kkrizka/powerboard_mass_test_adapter_active/bom.ods

Reference | Quantity | Value | Footprint | Datasheet | DigiKey | Cost / Item | Total Cost | 143.11
C303 C304 C305 C308 C310 C312 C313 C803 C804 | 9 | 10uF | Capacitors_SMD:C_0805 |  |  |  | 0
C101 C102 C103 C104 C106 C111 C112 C113 C114 C115 C116 C117 C118 C119 C301 C302 C306 C307 C309 C311 C314 C605 C802 C805 C9002 | 25 | 0.1uF | Capacitors_SMD:C_0805 |  |  |  | 0
C701 C703 C705 | 3 | 0.1μF | Capacitors_SMD:C_0805 |  |  |  | 0
C702 C704 C706 | 3 | 10μF | Capacitors_SMD:C_0805 |  |  |  | 0
C801 | 1 | C | Capacitors_SMD:C_0805 |  |  |  | 0
C9001 C9004 C9005 C9006 | 4 | 1uF | Capacitors_SMD:C_0805 |  |  |  | 0
D101 D102 D103 D104 D105 D106 D107 D108 D109 D701 D702 D703 D704 D705 D706 D707 D708 D709 D901 D902 | 20 | LED | LEDs:LED_1206_HandSoldering | https://www.lumex.com/content/files/ProductAttachment/SML-LX1206IW-TR.pdf | 67-1003-1-ND | 0.44 | 8.8
FL801 | 1 | 4700-003MLF | lbl_filters:4700-008MLF | http://www.ctscorp.com/wp-content/uploads/2016/01/4700-003.pdf | 410-1193-1-ND | 1.33 | 1.33
J1 | 1 | CONN_03X32 | lbl_conn:DIN-SIGNAL_R096FS-3_0C1-2 | https://b2b.harting.com/files/download/PRD/PDF_TS/0973296X801_100104712DRW068A.pdf | 1195-2893-ND | 4.95 | 4.95
J14001 J14002 J14003 J14004 J14005 J14006 J14007 | 7 | CONN_01X06 | Socket_Strips:Socket_Strip_Angled_1x06_Pitch2.54mm | http://www.sullinscorp.com/drawings/78_P(N)PxCxx1LGBN-RC,_10493-G.pdf | S5481-ND | 0.66 | 4.62
J2 | 1 | CONN_01X02 | Pin_Headers:Pin_Header_Straight_1x02_Pitch2.54mm_SMD_Pin1Right | https://www.molex.com/pdm_docs/sd/878980204_sd.pdf | WM9852-ND | 0.47 | 0.47
J201 J202 | 2 | CONN_02X10 | Pin_Headers:Pin_Header_Straight_2x10_Pitch2.54mm_SMD | http://www.sullinscorp.com/drawings/78_P(N)PxCxx1LGBN-RC,_10493-G.pdf | WM17456-ND | 1.92 | 3.84
J3 | 1 | Conn_02x18_Odd_Even | Pin_Headers:Pin_Header_Straight_2x18_Pitch2.54mm_SMD | http://www.sullinscorp.com/images/C10059.pdf | S2331E-18-ND | 3.23 | 3.23
J4 | 1 | Conn_02x09_Odd_Even | Socket_Strips:Socket_Strip_Straight_2x09_Pitch2.54mm_SMD | https://www.molex.com/pdm_docs/sd/015912180_sd.pdf | WM17455-ND | 1.43 | 1.43
J5 J6 | 2 | CONN_02X06 | Socket_Strips:Socket_Strip_Straight_2x06_Pitch2.54mm_SMD | https://cdn.amphenol-icc.com/media/wysiwyg/files/drawing/95278.pdf | 609-5754-ND | 0.78 | 1.56
J801 | 1 | CONN_02X02 | Connectors_Molex:Molex_MiniFit-JR-5569-04A2_2x02x4.20mm_Angled | https://www.molex.com/pdm_docs/pk/PK-5569-002.pdf | WM21364-ND | 2.08 | 2.08
J802 | 1 | CONN_02X01 | lbl_conn:TerminalBlock_Pheonix_MKDS5-2pol | https://media.digikey.com/pdf/Data%20Sheets/Phoenix%20Contact%20PDFs/1714971.pdf | 277-1271-ND | 1.6 | 1.6
J803 | 1 | LEMO2 | lbl_conn:lemo_epb00250ntn | http://www.lemo.com/pdf/EPB.00.250.NTN.pdf | 1124-1424-ND | 21.15 | 21.15
J901 | 1 | CONN_02X04 | Pin_Headers:Pin_Header_Straight_2x04_Pitch2.54mm_SMD | https://www.molex.com/pdm_docs/sd/015910080_sd.pdf | WM17458-ND | 0.74 | 0.74
JP1201 JP1202 JP1203 | 3 | Jumper_NC_Dual | Pin_Headers:Pin_Header_Straight_1x03_Pitch2.54mm_SMD_Pin1Right | http://support.sullinscorp.com/attachments/token/zIL3zA2RvRp1z4YZ6UU4t3JTD/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 | S1013EC-03-ND | 0.25 | 0.75
JP901 JP902 JP903 | 3 | Jumper | Pin_Headers:Pin_Header_Straight_1x02_Pitch2.54mm_SMD_Pin1Right | https://www.molex.com/pdm_docs/sd/878980204_sd.pdf | WM9852-ND | 0.47 | 1.41
Q101 Q102 Q103 Q104 Q105 Q106 Q107 Q108 Q109 | 9 | BSH105,215 | TO_SOT_Packages_SMD:SOT-23 | https://assets.nexperia.com/documents/data-sheet/BSH105.pdf | 1727-4924-1-ND | 0.56 | 5.04
Q111 Q112 Q113 Q114 Q115 Q116 Q117 Q118 Q119 | 9 | NTD4858N | TO_SOT_Packages_SMD:TO-252-2 | http://www.onsemi.com/pub/Collateral/NTD4858N-D.PDF | NTD4858NT4GOSCT-ND | 0.8 | 7.2
Q701 Q702 Q703 Q704 Q705 Q706 Q707 Q708 Q709 | 9 | SSM3J355R | TO_SOT_Packages_SMD:SOT-23 | https://toshiba.semicon-storage.com/info/docget.jsp?did=55743&prodName=SSM3J355R | SSM3J355RLFCT-ND | 0.5 | 4.5
R101 R102 R103 R104 R105 R106 R107 R108 R109 R701 R702 R703 R704 R705 R706 R707 R708 R709 R902 R903 | 20 | 620 | Resistors_SMD:R_0805 | http://www.vishay.com/docs/20035/dcrcwe3.pdf | 541-620CCT-ND | 0.1 | 2
R111 R112 R113 R114 R115 R116 R117 R118 R119 | 9 | 25m | Resistors_SMD:R_2512 | https://riedon.com/media/pdf/CSR.pdf | 696-1675-1-ND | 0.64 | 5.76
R1203 R1204 R1205 R1211 R1212 R1213 R1214 R1215 R1216 R1217 R1218 R1219 R1221 R1222 R1223 R1224 R1225 R1226 R1227 R1228 R1229 R1230 R1231 R1232 R1233 R1234 R1235 R1236 R1240 R1241 R1242 R1243 R1244 R1245 R1246 | 35 | 2k | Resistors_SMD:R_0805 | http://www.vishay.com/docs/28773/crcwce3.pdf | 541-4134-1-ND | 0.1 | 3.5
R131 R132 R133 R134 R135 R136 R137 R138 R139 | 9 | 4.02k | Resistors_SMD:R_0805 | http://www.vishay.com/docs/20035/dcrcwe3.pdf | 541-4.02KCCT-ND | 0.1 | 0.9
R141 R142 R143 R144 R145 R146 R147 R148 R149 R151 R152 R153 R154 R155 R156 R157 R158 R159 R301 R302 R303 R304 R305 R306 R307 | 25 | 10k | Resistors_SMD:R_0805 |  |  |  | 0
R1200 R1201 R1202 R1206 R121 R122 R123 R124 R125 R126 R127 R128 R129 R308 R309 R310 R720 R721 R807 R901 R907 | 21 | 100k | Resistors_SMD:R_0805 |  |  |  | 0
R711 R712 R713 R714 R715 R716 R717 R718 R719 | 9 | 30k | Resistors_SMD:R_0805 |  |  |  | 0
R801 | 1 | R | Resistors_SMD:R_0805 |  |  |  | 0
R802 | 1 | 5m | Resistors_SMD:R_2512 | http://www.vishay.com/docs/20019/rcwe.pdf | 541-2727-1-ND | 0.68 | 0.68
R803 R804 | 2 | 100m | Resistors_SMD:R_0805 |  |  |  | 0
R805 | 1 | 35k | Resistors_SMD:R_0805 |  |  |  | 0
R806 | 1 | 90.9k | Resistors_SMD:R_0805 |  |  |  | 0
R812 | 1 | 250k | Resistors_SMD:R_0805 |  |  |  | 0
R813 R814 | 2 | 500k | Resistors_SMD:R_0805 |  |  |  | 0
R904 | 1 | 83k | Resistors_SMD:R_0805 |  |  |  | 0
R905 | 1 | 140k | Resistors_SMD:R_0805 |  |  |  | 0
R906 R908 | 2 | 25k | Resistors_SMD:R_0805 |  |  |  | 0
TH301 TH302 TH303 TH304 TH305 TH306 TH307 | 7 | Thermistor_NTC | Resistors_SMD:R_0805 | https://product.tdk.com/info/en/catalog/datasheets/503022/tpd_automotive_ntc-thermistor_ntcg_en.pdf | 445-180089-1-ND | 0.3 | 2.1
U101 U102 U103 | 3 | LM324 | Housings_SSOP:TSSOP-14_4.4x5mm_Pitch0.65mm | http://www.ti.com/lit/ds/symlink/lm324k.pdf | 296-18453-1-ND | 0.49 | 1.47
U1201 U1202 | 2 | TCA9548A_TSSOP | Housings_SSOP:TSSOP-24_4.4x7.8mm_Pitch0.65mm | http://www.ti.com/lit/ds/symlink/tca9548a.pdf | 296-34905-1-ND | 1.55 | 3.1
U301 U304 | 2 | AD7997 | Housings_SSOP:TSSOP-20_4.4x6.5mm_Pitch0.65mm | http://www.analog.com/media/en/technical-documentation/data-sheets/AD7997_7998.pdf | AD7997BRUZ-0-ND | 5.94 | 11.88
U302 U303 U305 | 3 | DAC5574 | Housings_SSOP:MSOP-10_3x3mm_Pitch0.5mm | http://www.ti.com/lit/ds/symlink/dac5574.pdf | 296-48522-1-ND | 3.72 | 11.16
U701 U702 U703 | 3 | MCP3428 | Housings_SSOP:TSSOP-14_4.4x5mm_Pitch0.65mm | http://www.microchip.com/mymicrochip/filehandler.aspx?ddocname=en546216 | MCP3428-E/SL-ND | 3.67 | 11.01
U801 | 1 | AD7993 | Housings_SSOP:TSSOP-16_4.4x5mm_Pitch0.65mm | http://www.analog.com/media/en/technical-documentation/data-sheets/AD7993_7994.pdf | AD7993BRUZ-0-ND | 6.6 | 6.6
U802 U803 U804 | 3 | INA138 | TO_SOT_Packages_SMD:SOT-23-5_HandSoldering | http://www.ti.com/lit/ds/symlink/ina138.pdf | 296-17936-1-ND | 1.74 | 5.22
U901 | 1 | LM321 | TO_SOT_Packages_SMD:SOT-23-5_HandSoldering | http://www.ti.com/lit/ds/symlink/lm321.pdf | LM321MFX/NOPBCT-ND | 0.65 | 0.65
U902 U903 | 2 | ADP123 | TO_SOT_Packages_SMD:TSOT-23-5_HandSoldering | http://www.analog.com/media/en/technical-documentation/data-sheets/ADP122_123.pdf | ADP123AUJZ-R7CT-ND | 1.19 | 2.38
ZED201 | 1 | MicroZed | zed:microzed_noholes | http://www.zedboard.org/product/microzed | AES-Z7MB-7Z010-G | 0 | 0
 | 2 | BergStak 100 Position Connector Plug | zed:microzed_noholes | https://cdn.amphenol-icc.com/media/wysiwyg/files/drawing/61083.pdf | 609-1693-1-ND | 7.46 | 14.92
