kkrizka/powerboard_mass_test_adapter_active/schematic/pbv2_mass_test_adapter_active.pdf

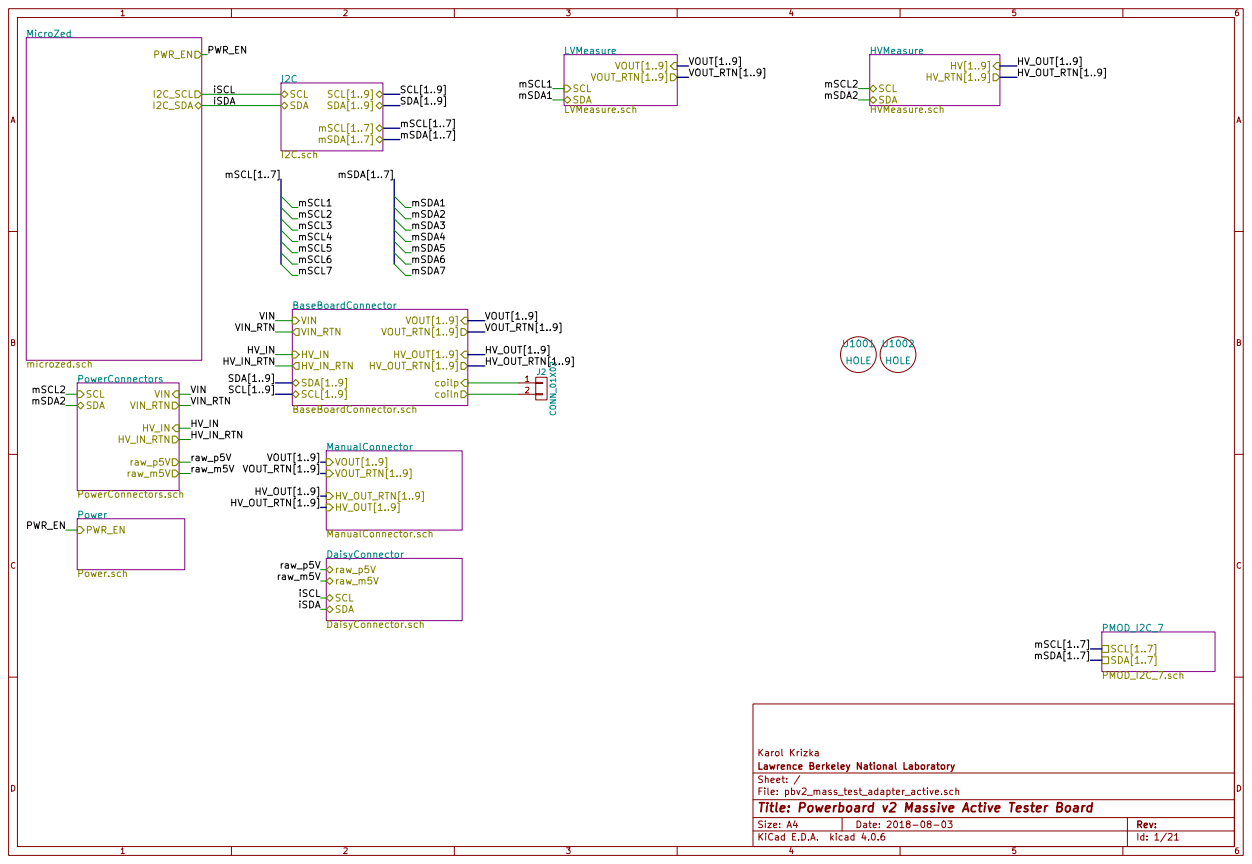
[picture p1: page 1]

File: pbv2_mass_test_adapter_active.sch Sheet: / Lawrence Berkeley National Laboratory Karol Krizka

Id: 1/21 Title: Powerboard v2 Massive Active Tester Board

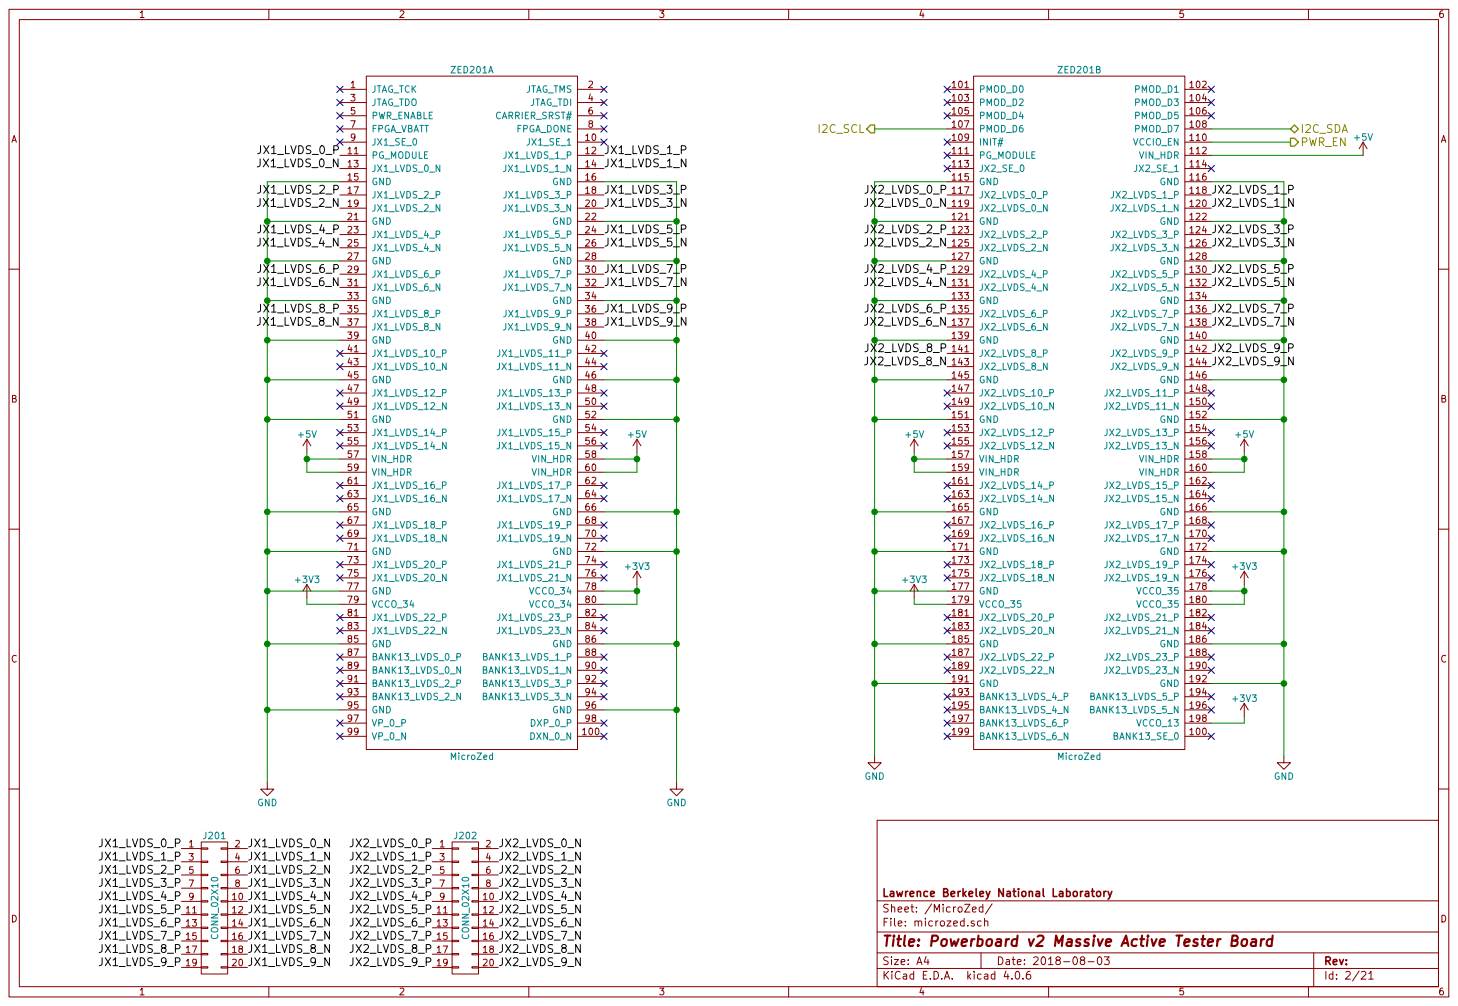
[picture p2: page 2]

File: microzed.sch Sheet: /MicroZed/ Lawrence Berkeley National Laboratory

Id: 2/21 Title: Powerboard v2 Massive Active Tester Board

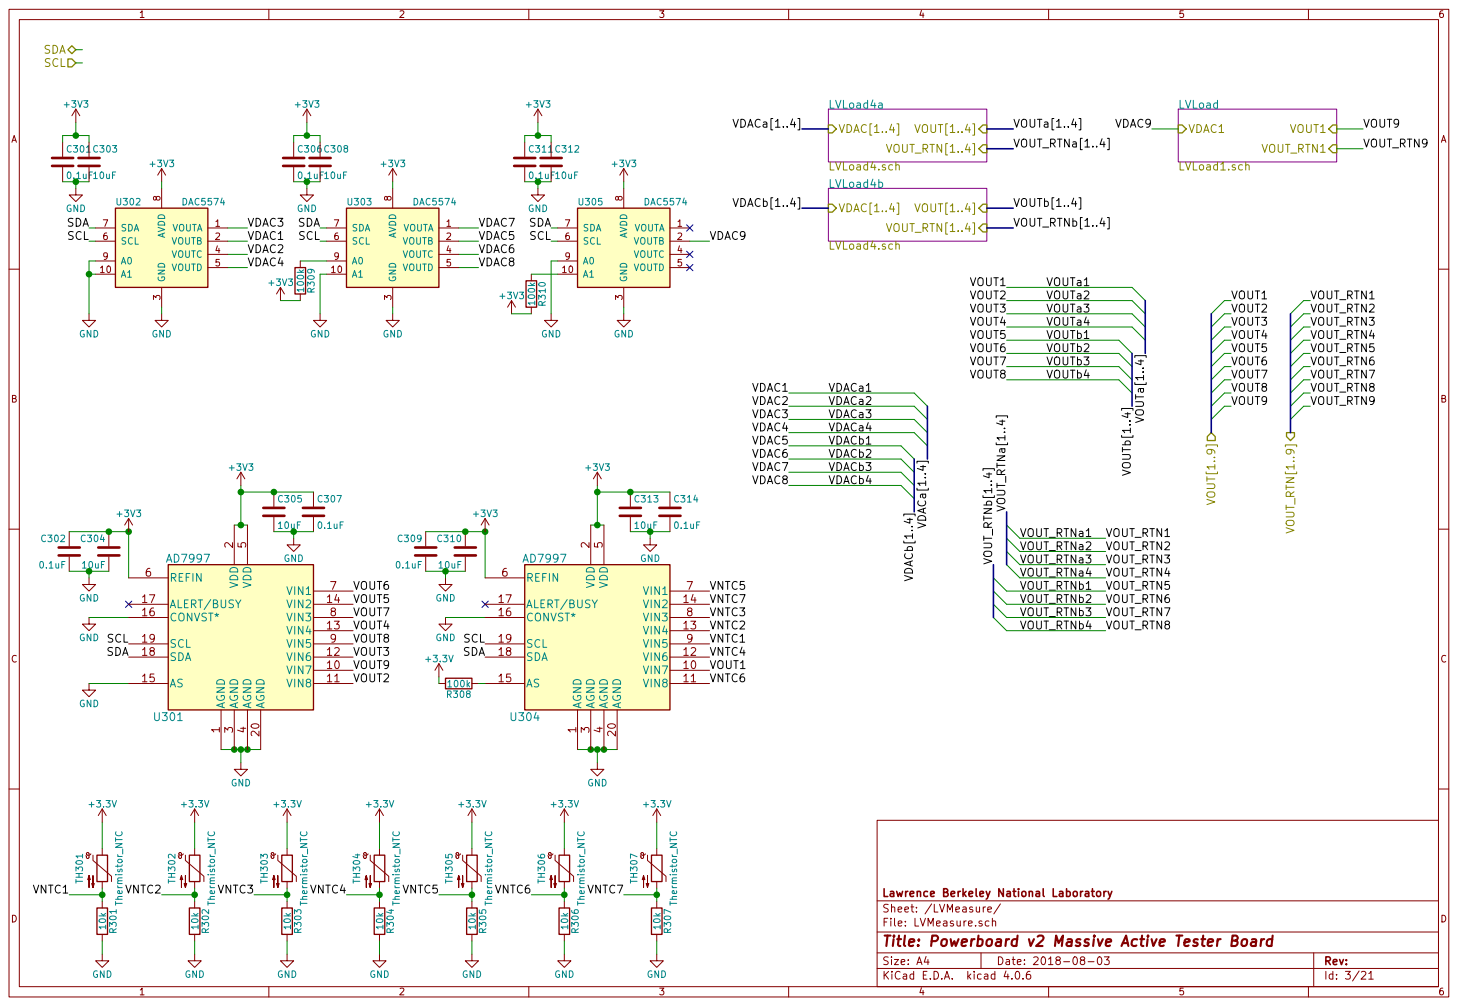
[picture p3: page 3]

3 VOUTC 4 VOUTD 5 SCL 6 SDA 7 AVDD

5 REFIN 6 VIN1 7 VIN3 8 VIN5 9 VIN7 10 AGND 20 VIN8 11 VIN6 12 VIN4 13 VIN2 14 AS 15 CONVST* 16 ALERT/BUSY 17 SDA 18 SCL 19U304AD7997 R301 10k TH301 Thermistor_NTC

5 REFIN 6 VIN1 7 VIN3 8 VIN5 9 VIN7 10 AGND 20 VIN8 11 VIN6 12 VIN4 13 VIN2 14 AS 15 CONVST* 16 ALERT/BUSY 17 SDA 18 SCL 19U301AD7997 VOUT9 GND SCL

File: LVMeasure.sch Sheet: /LVMeasure/ Lawrence Berkeley National Laboratory

Id: 3/21 Title: Powerboard v2 Massive Active Tester Board

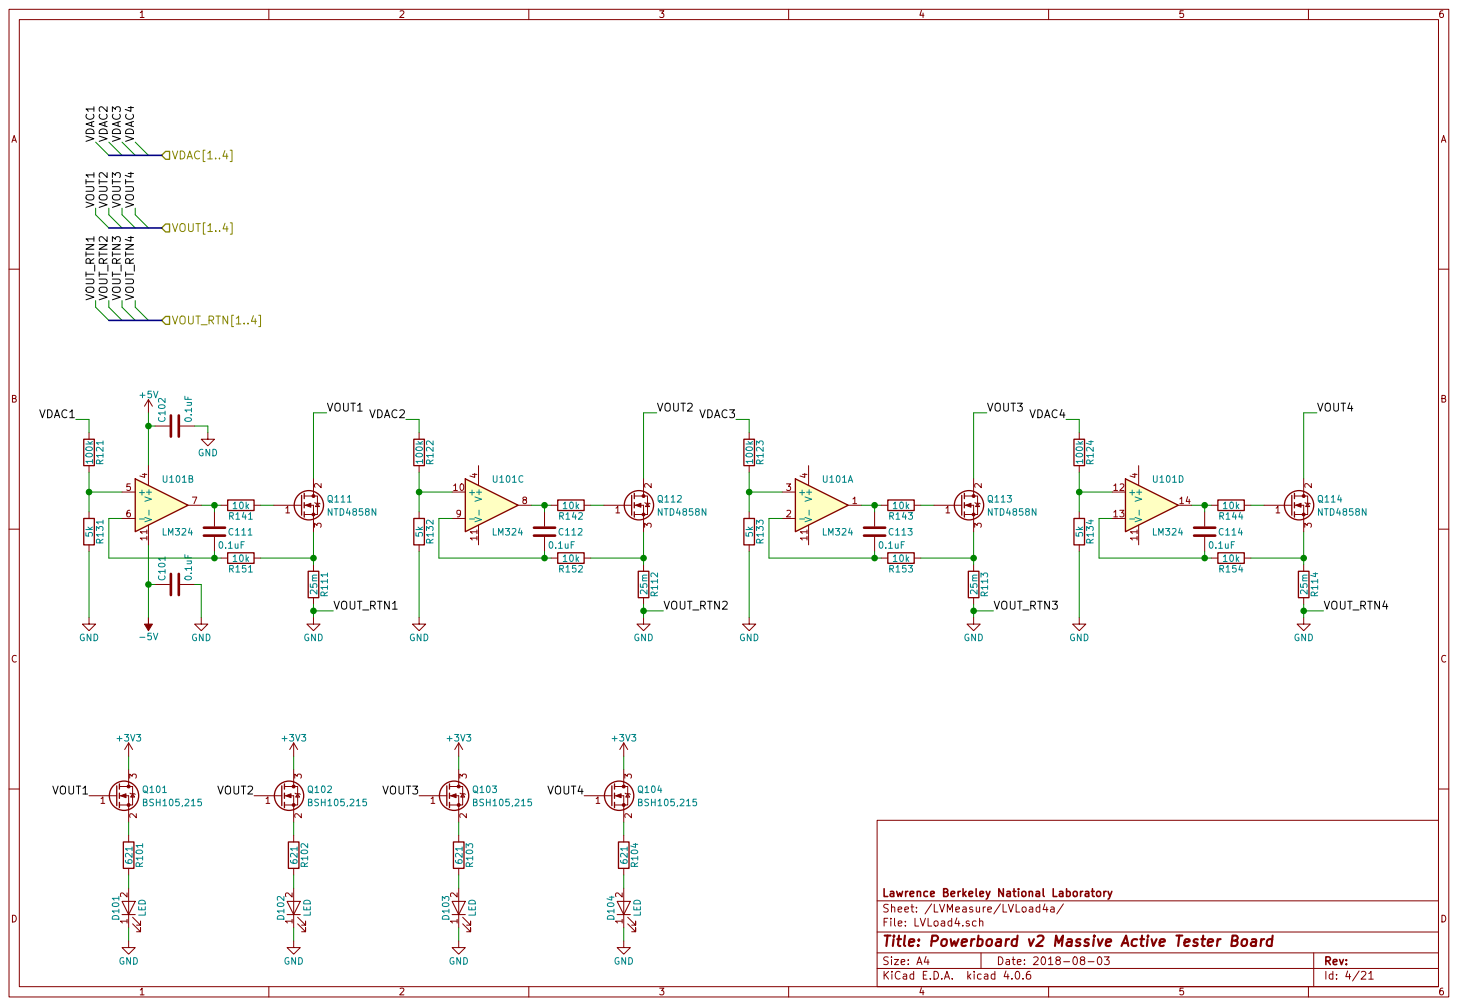
[picture p4: page 4]

File: LVLoad4.sch Sheet: /LVMeasure/LVLoad4a/ Lawrence Berkeley National Laboratory V+

2 3 Q114 NTD4858N GND GND GND GND

Id: 4/21 Title: Powerboard v2 Massive Active Tester Board

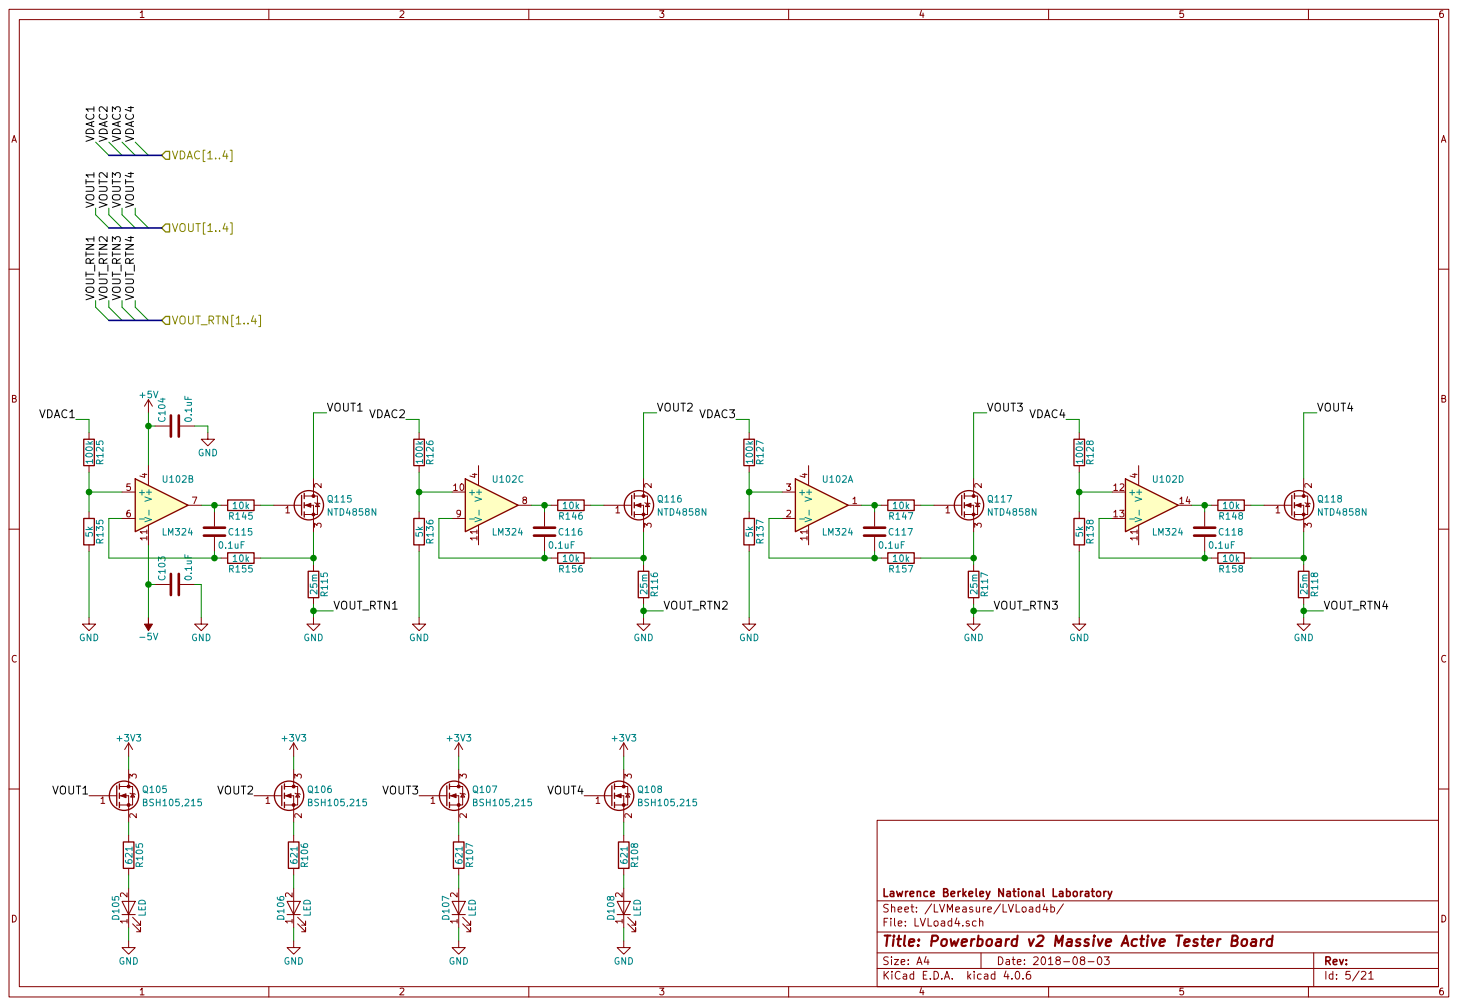
[picture p5: page 5]

File: LVLoad4.sch Sheet: /LVMeasure/LVLoad4b/ Lawrence Berkeley National Laboratory V+

2 3 Q118 NTD4858N GND GND GND GND

Id: 5/21 Title: Powerboard v2 Massive Active Tester Board

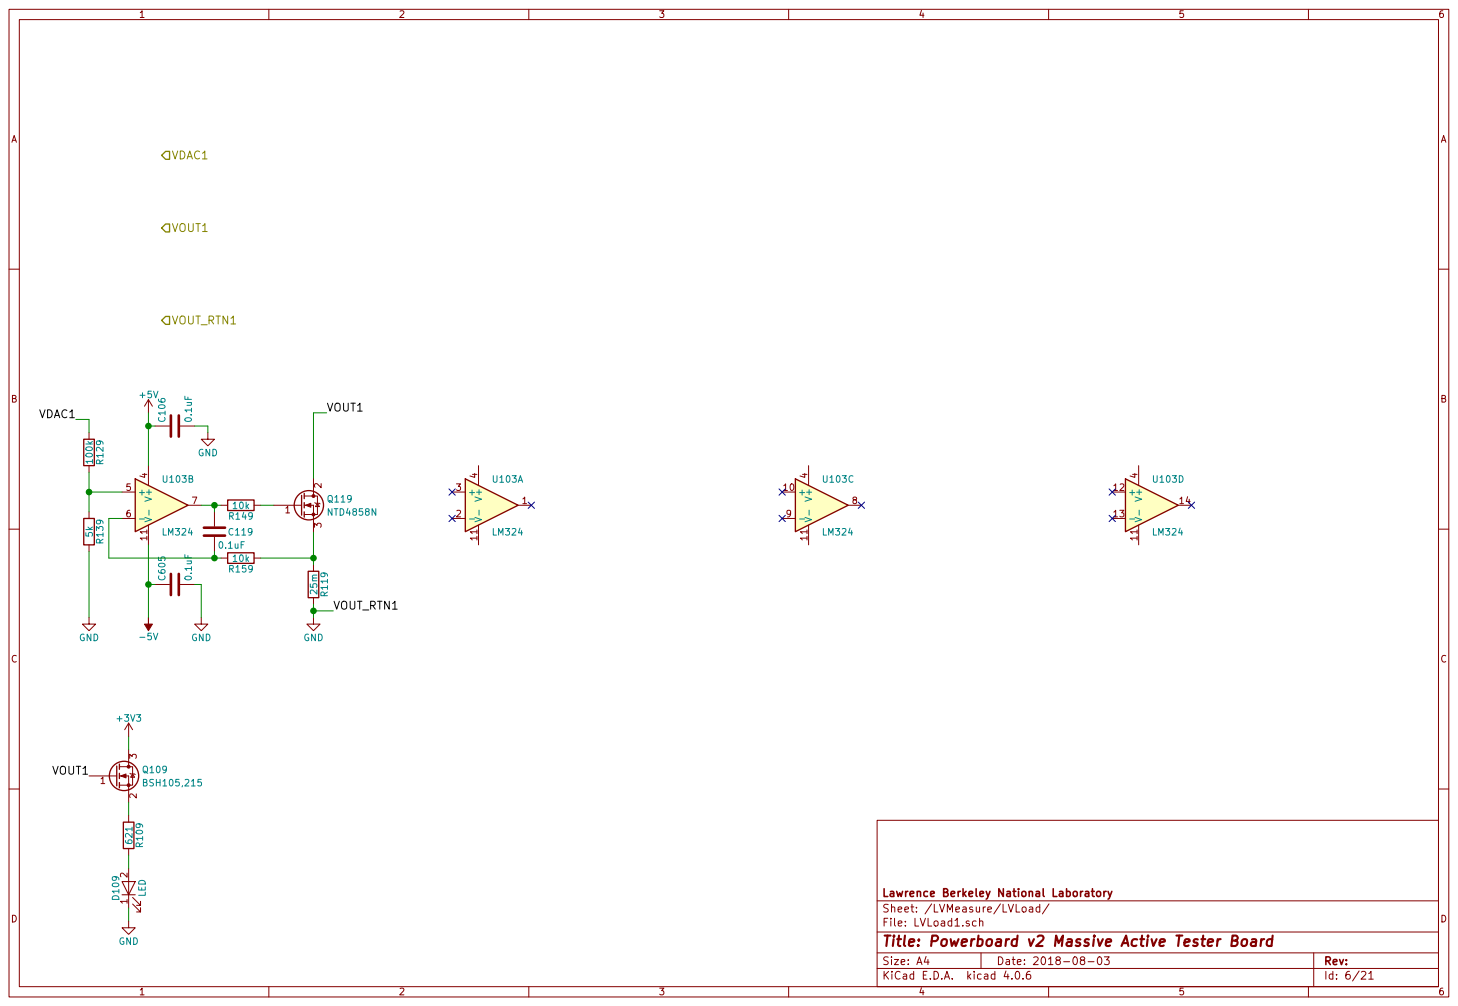
[picture p6: page 6]

File: LVLoad1.sch Sheet: /LVMeasure/LVLoad/ Lawrence Berkeley National Laboratory V+

Id: 6/21 Title: Powerboard v2 Massive Active Tester Board

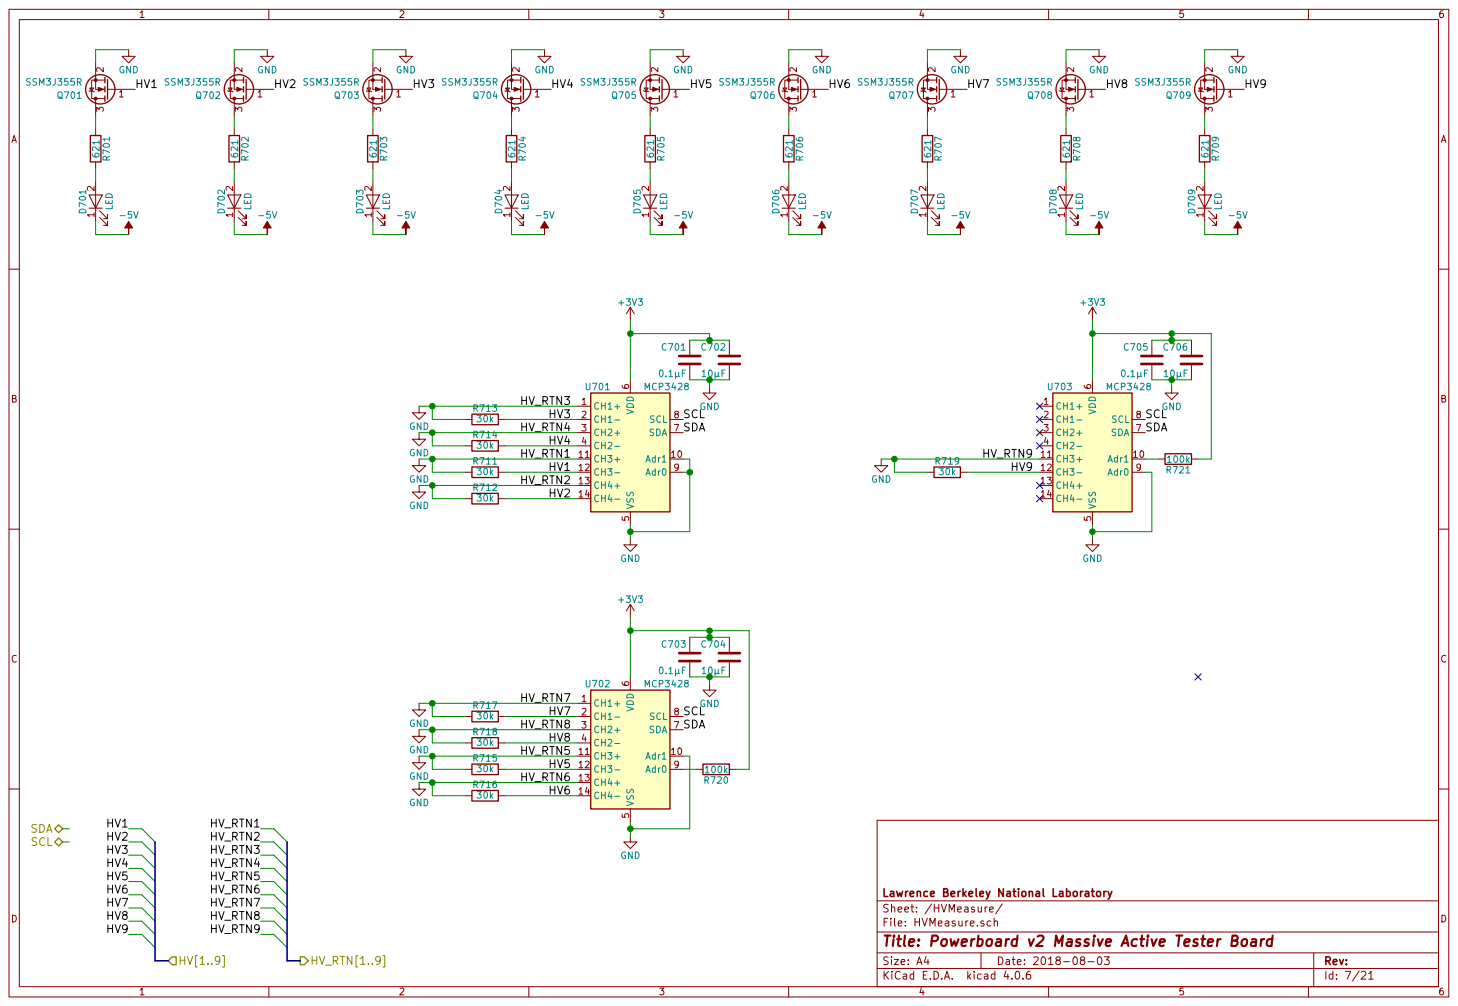
[picture p7: page 7]

6 SDA 7 SCL 8 Adr0 9 Adr1 10 CH3+ 11 CH3- 12 CH4+ 13 CH4- 14U701 MCP3428 GND GND GND GND GND GND GND GND GND GND GND GND GND GND GND GND GND GND

File: HVMeasure.sch Sheet: /HVMeasure/ Lawrence Berkeley National Laboratory

Id: 7/21 Title: Powerboard v2 Massive Active Tester Board

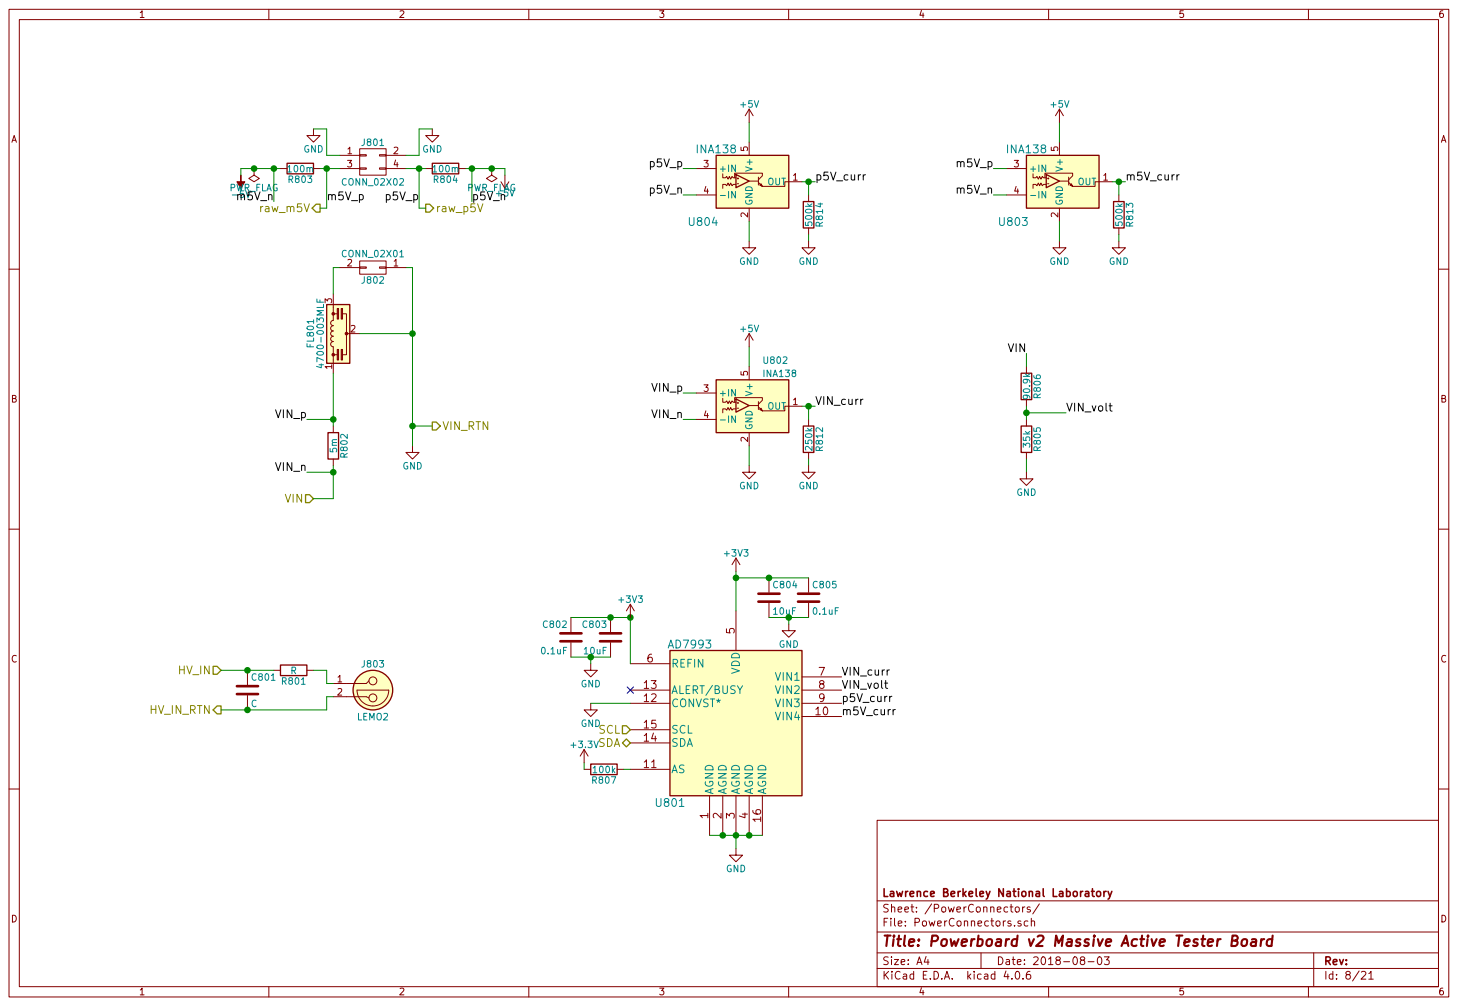
[picture p8: page 8]

5 REFIN 6 VIN1 7 VIN2 8 VIN3 9 VIN4 10 AS 11 CONVST* 12 ALERT/BUSY 13 SDA 14 SCL 15 AGND 16 U801AD7993 VIN_volt GND GND

File: PowerConnectors.sch Sheet: /PowerConnectors/ Lawrence Berkeley National Laboratory

Id: 8/21 Title: Powerboard v2 Massive Active Tester Board

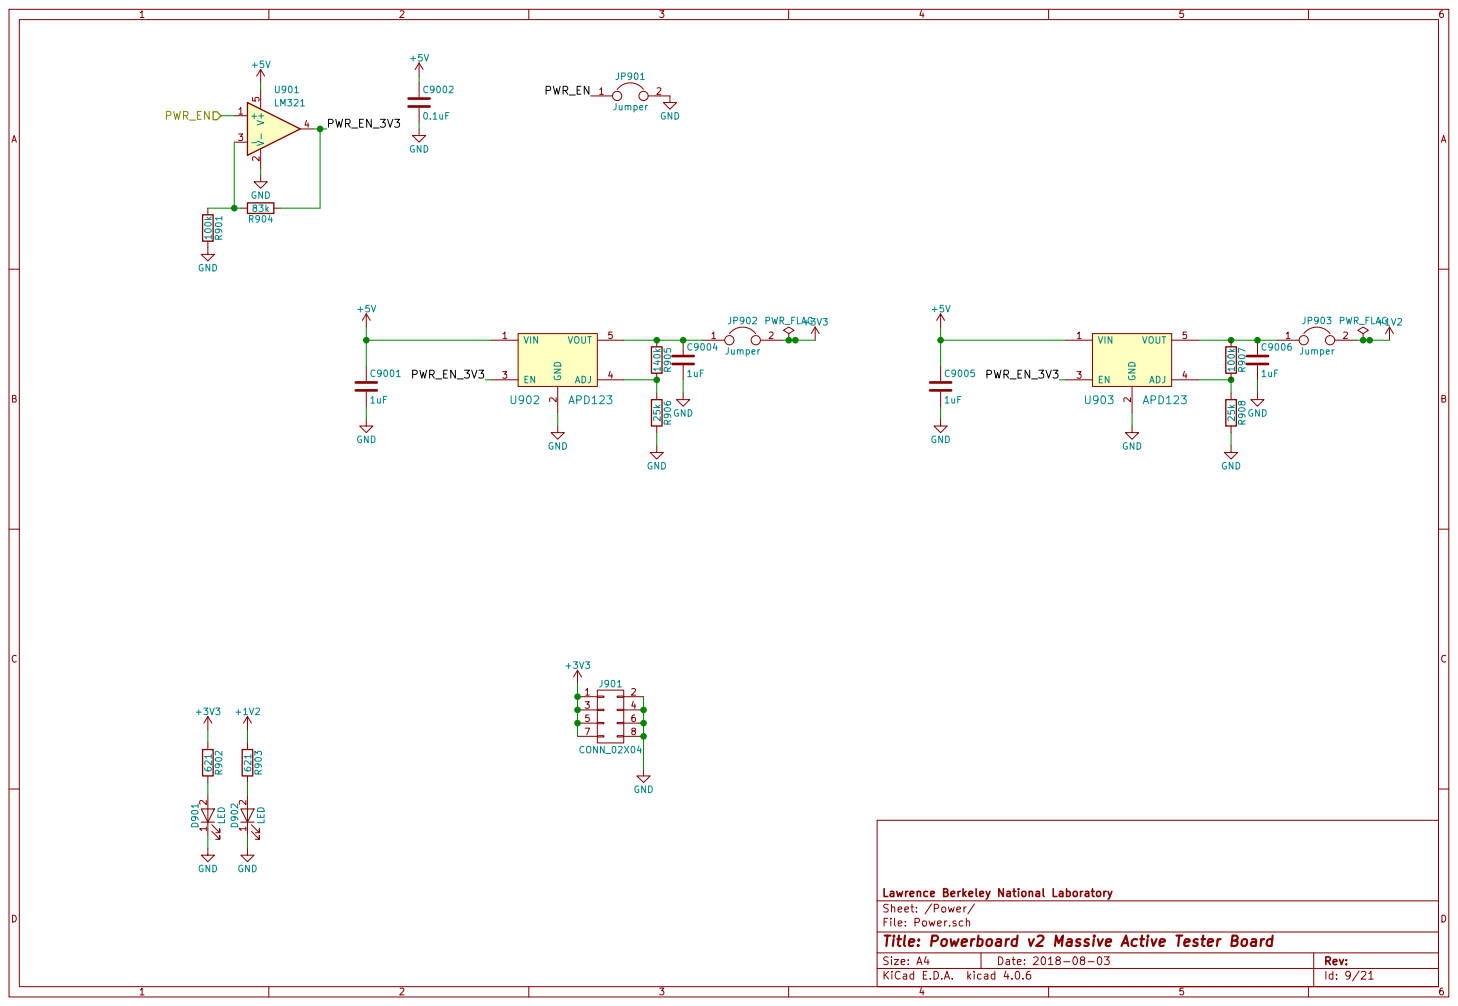
[picture p9: page 9]

File: Power.sch Sheet: /Power/ Lawrence Berkeley National Laboratory GND140k R905 R906 25k C9001

Id: 9/21 Title: Powerboard v2 Massive Active Tester Board

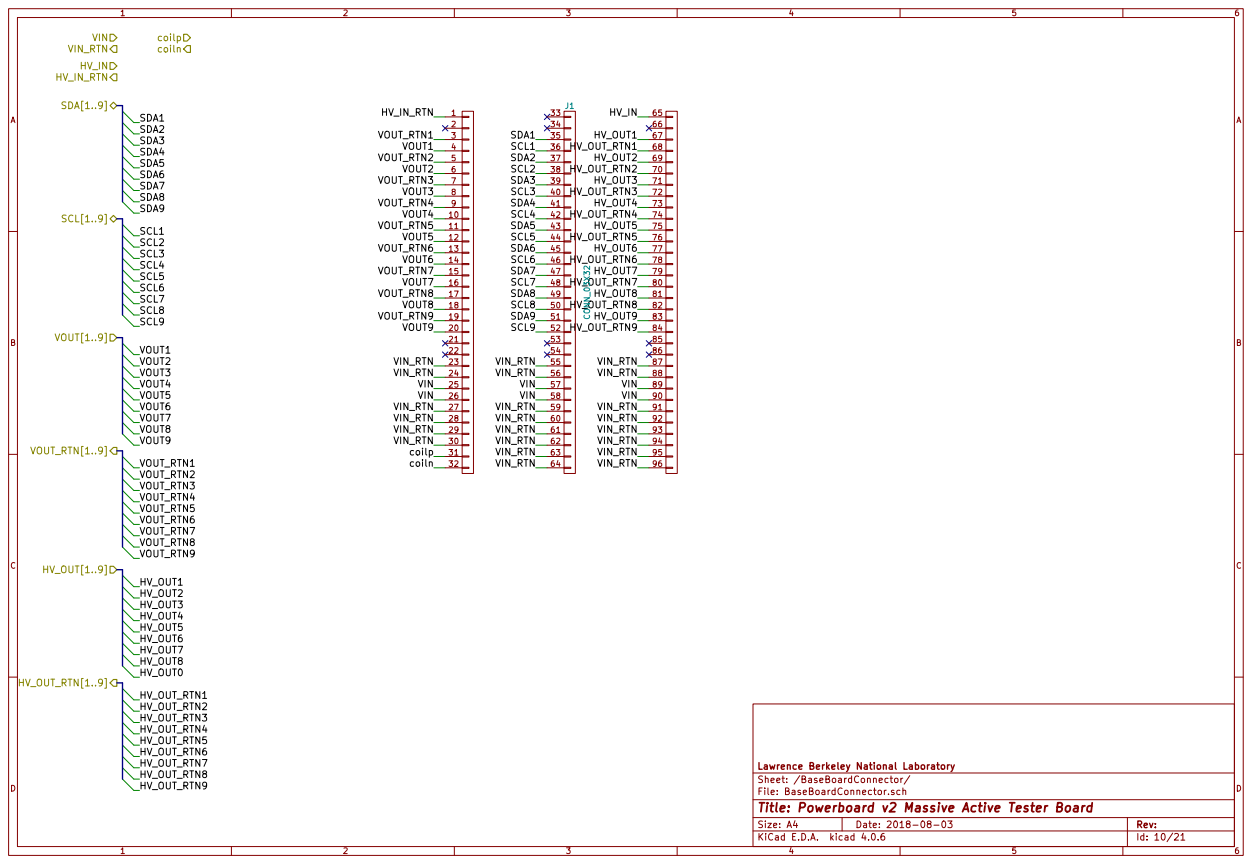
[picture p10: page 10]

File: BaseBoardConnector.sch Sheet: /BaseBoardConnector/ Lawrence Berkeley National Laboratory

Id: 10/21 Title: Powerboard v2 Massive Active Tester Board

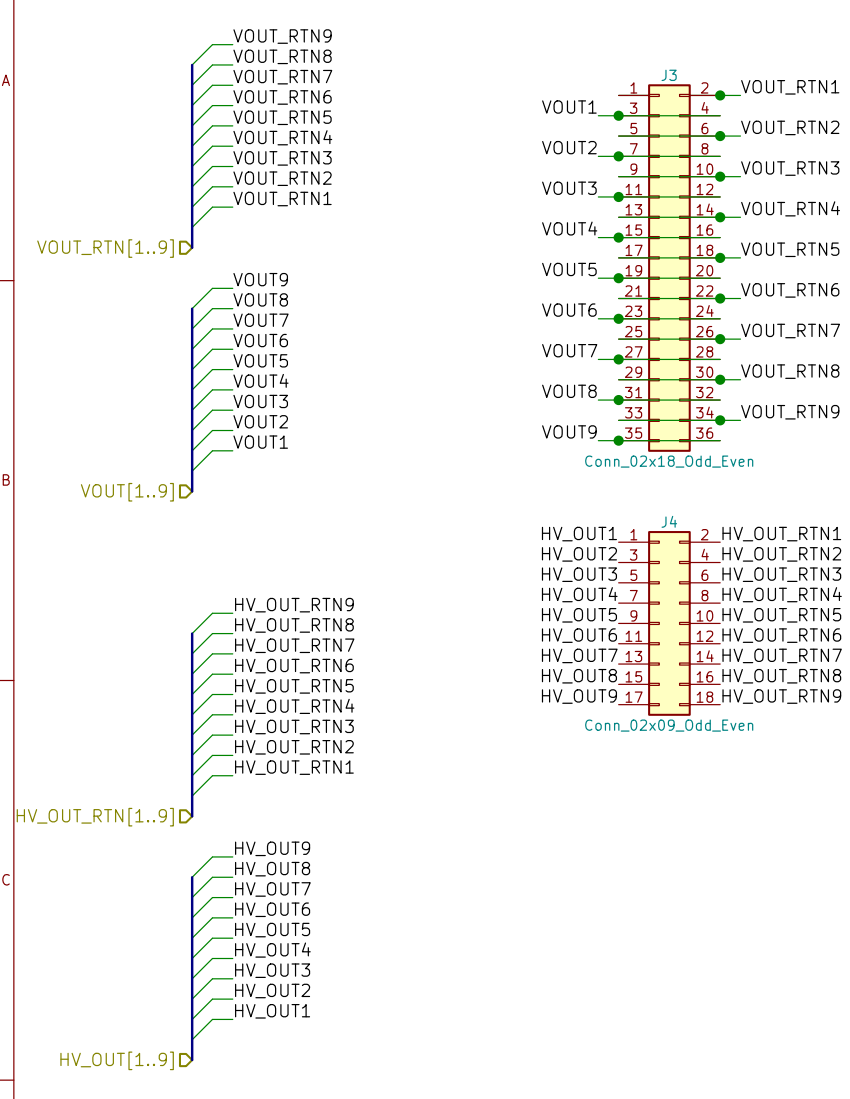
[picture p11: page 11]

File: ManualConnector.sch Sheet: /ManualConnector/ Lawrence Berkeley National Laboratory

Id: 11/21 Title: Powerboard v2 Massive Active Tester Board

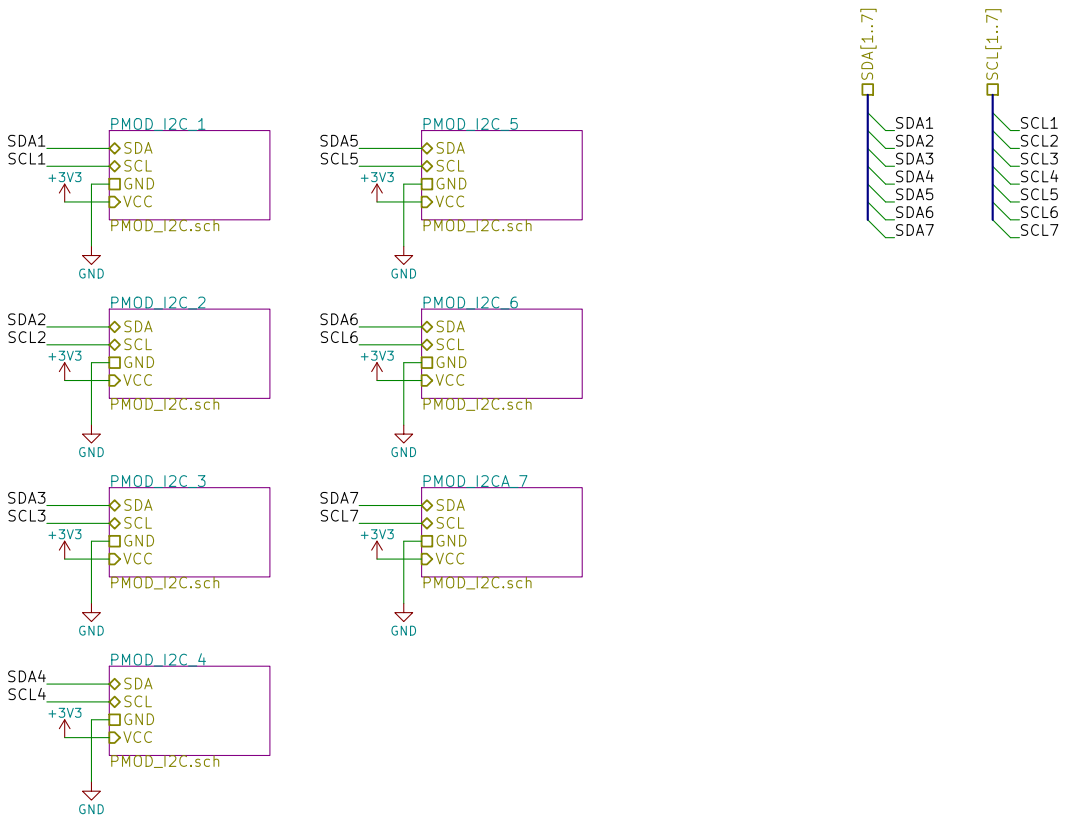
[picture p12: page 12]

Lawrence Berkeley National Laboratory
Sheet: /PMOD_I2C_7/
File: PMOD_I2C_7.sch
Id: 12/21 Title: Powerboard v2 Massive Active Tester Board

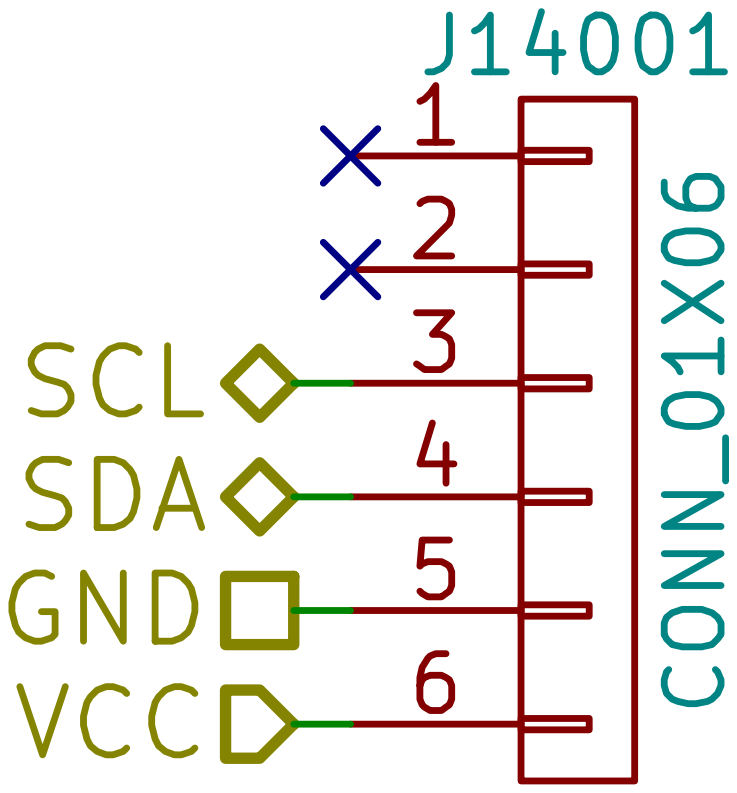
[picture p13: page 13]

Lawrence Berkeley National Laboratory
Sheet: /PMOD_I2C_7/PMOD_I2C_1/
File: PMOD_I2C.sch
Id: 13/21 Title: Powerboard v2 Massive Active Tester Board

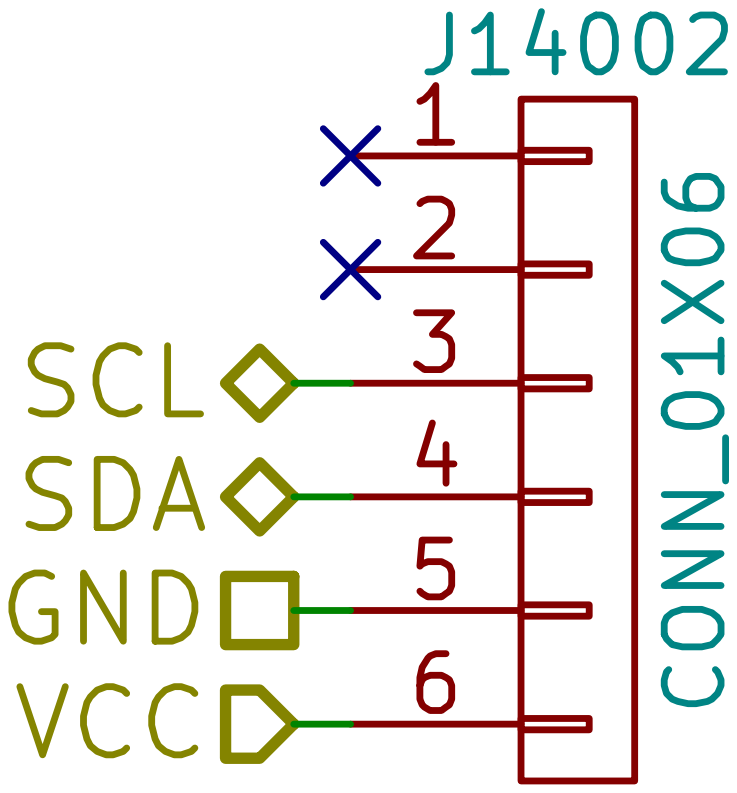
[picture p14: page 14]

Lawrence Berkeley National Laboratory
Sheet: /PMOD_I2C_7/PMOD_I2C_2/
File: PMOD_I2C.sch
Id: 14/21 Title: Powerboard v2 Massive Active Tester Board

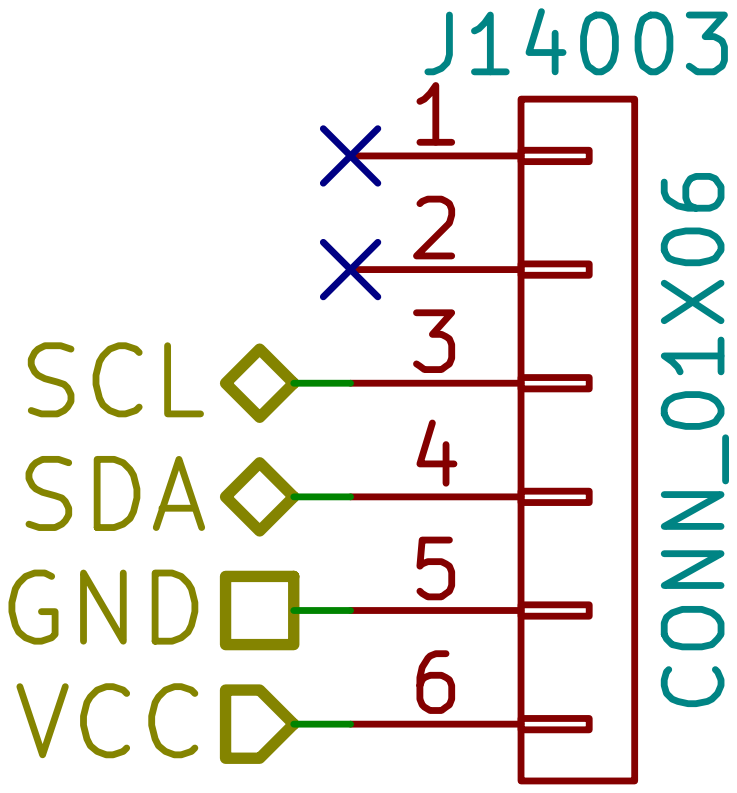
[picture p15: page 15]

Lawrence Berkeley National Laboratory
Sheet: /PMOD_I2C_7/PMOD_I2C_3/
File: PMOD_I2C.sch
Id: 15/21 Title: Powerboard v2 Massive Active Tester Board

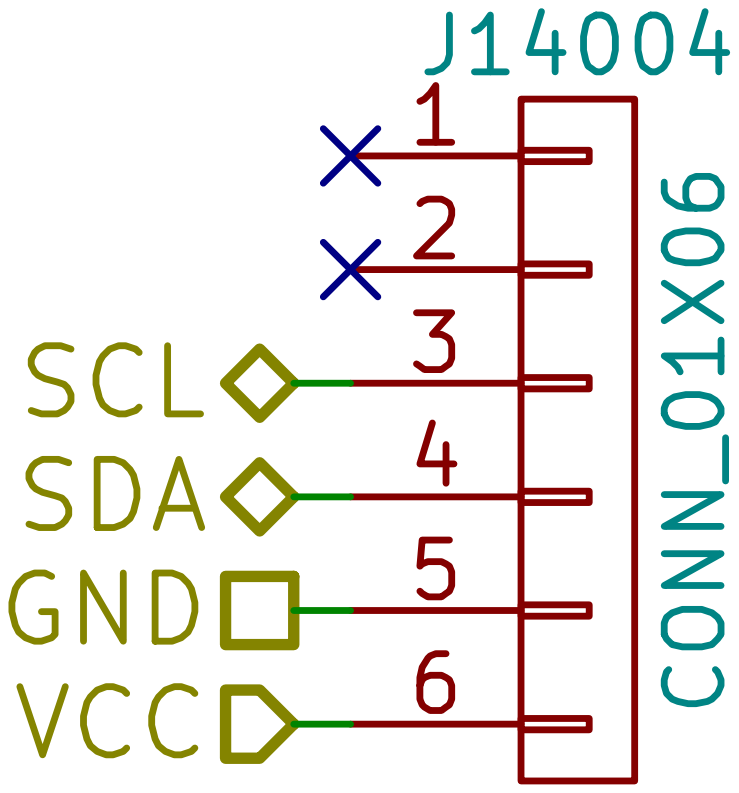
[picture p16: page 16]

Lawrence Berkeley National Laboratory
Sheet: /PMOD_I2C_7/PMOD_I2C_4/
File: PMOD_I2C.sch
Id: 16/21 Title: Powerboard v2 Massive Active Tester Board

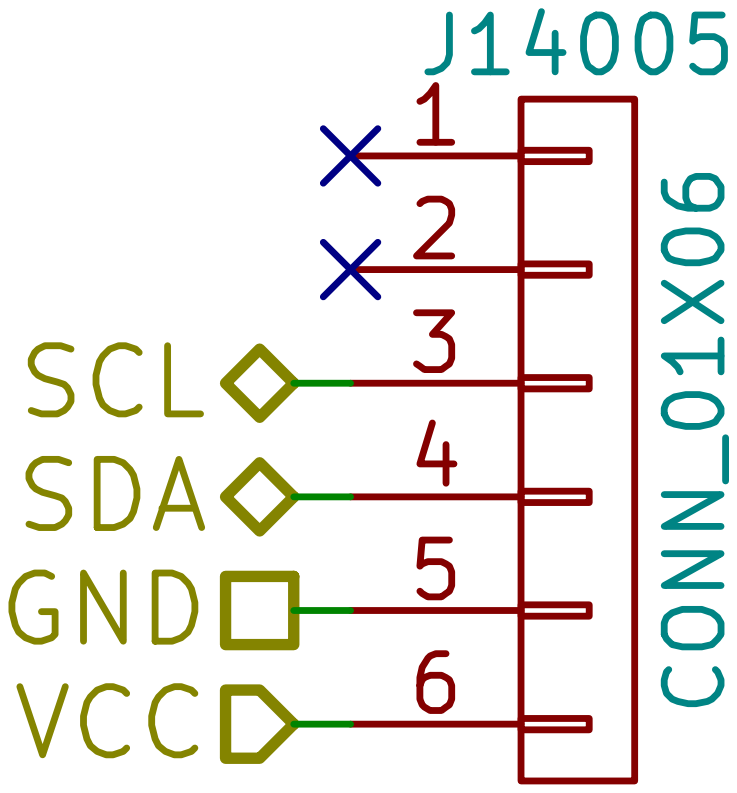
[picture p17: page 17]

Lawrence Berkeley National Laboratory
Sheet: /PMOD_I2C_7/PMOD_I2C_5/
File: PMOD_I2C.sch
Id: 17/21 Title: Powerboard v2 Massive Active Tester Board

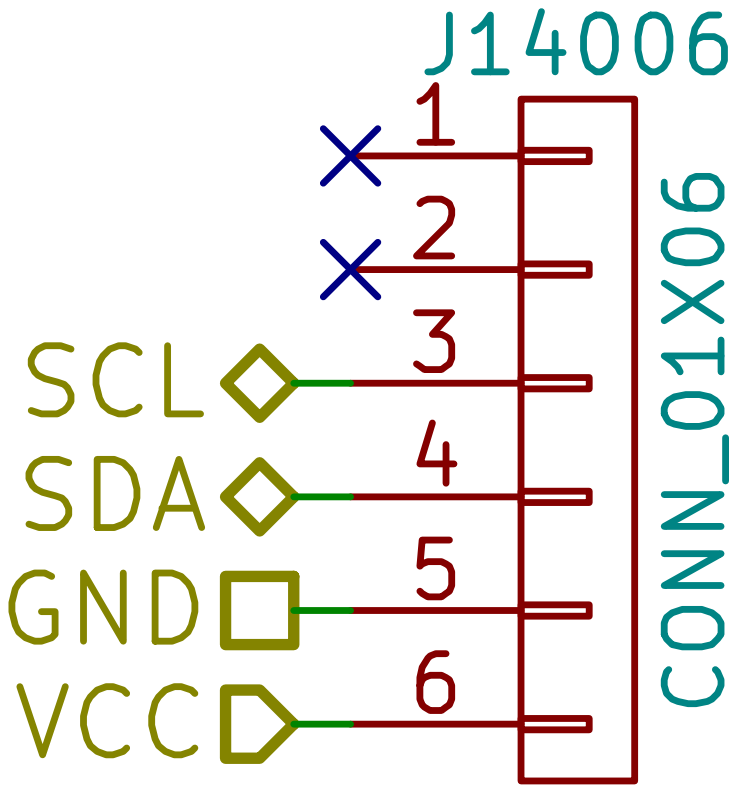
[picture p18: page 18]

Lawrence Berkeley National Laboratory
Sheet: /PMOD_I2C_7/PMOD_I2C_6/
File: PMOD_I2C.sch
Id: 18/21 Title: Powerboard v2 Massive Active Tester Board

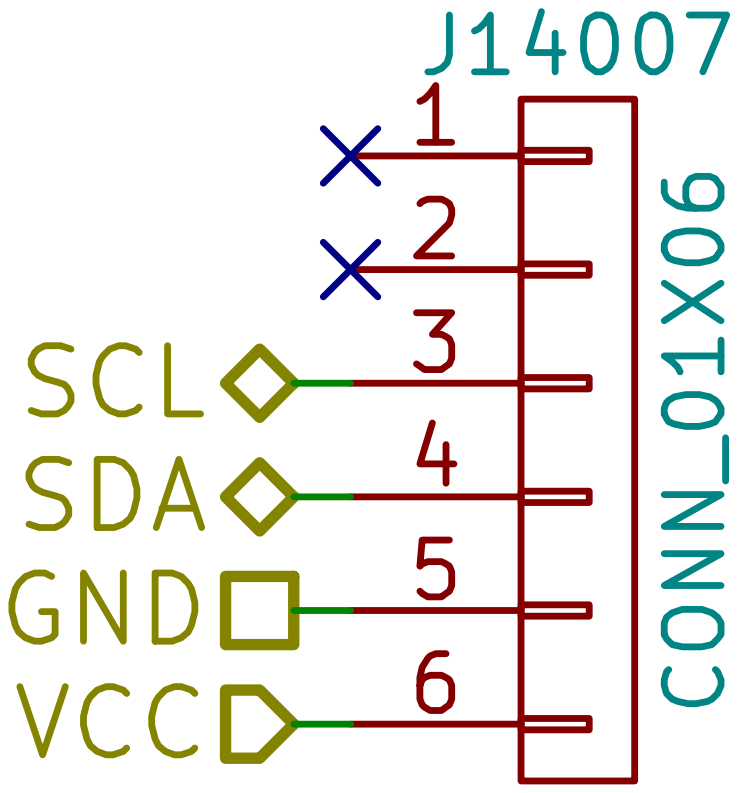
[picture p19: page 19]

Lawrence Berkeley National Laboratory
Sheet: /PMOD_I2C_7/PMOD_I2CA_7/
File: PMOD_I2C.sch
Id: 19/21 Title: Powerboard v2 Massive Active Tester Board

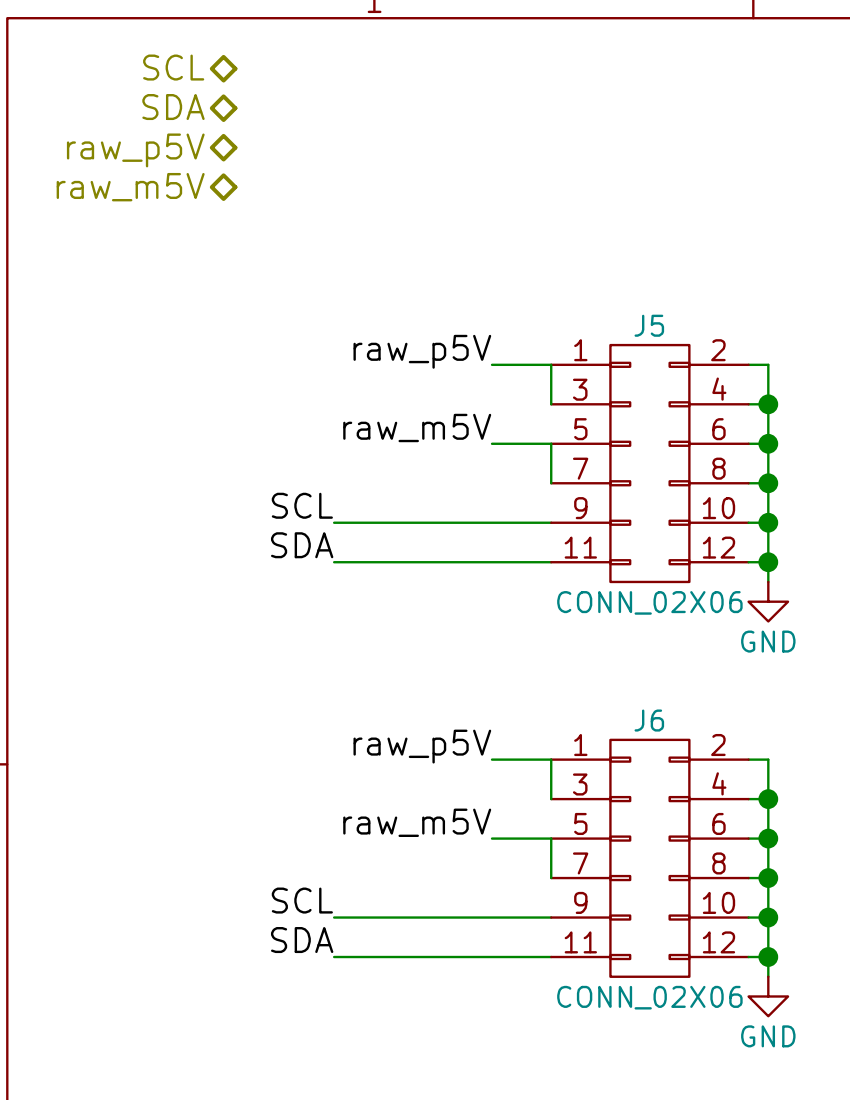
[picture p20: page 20]

Lawrence Berkeley National Laboratory
Sheet: /DaisyConnector/
File: DaisyConnector.sch
Id: 20/21 Title: Powerboard v2 Massive Active Tester Board

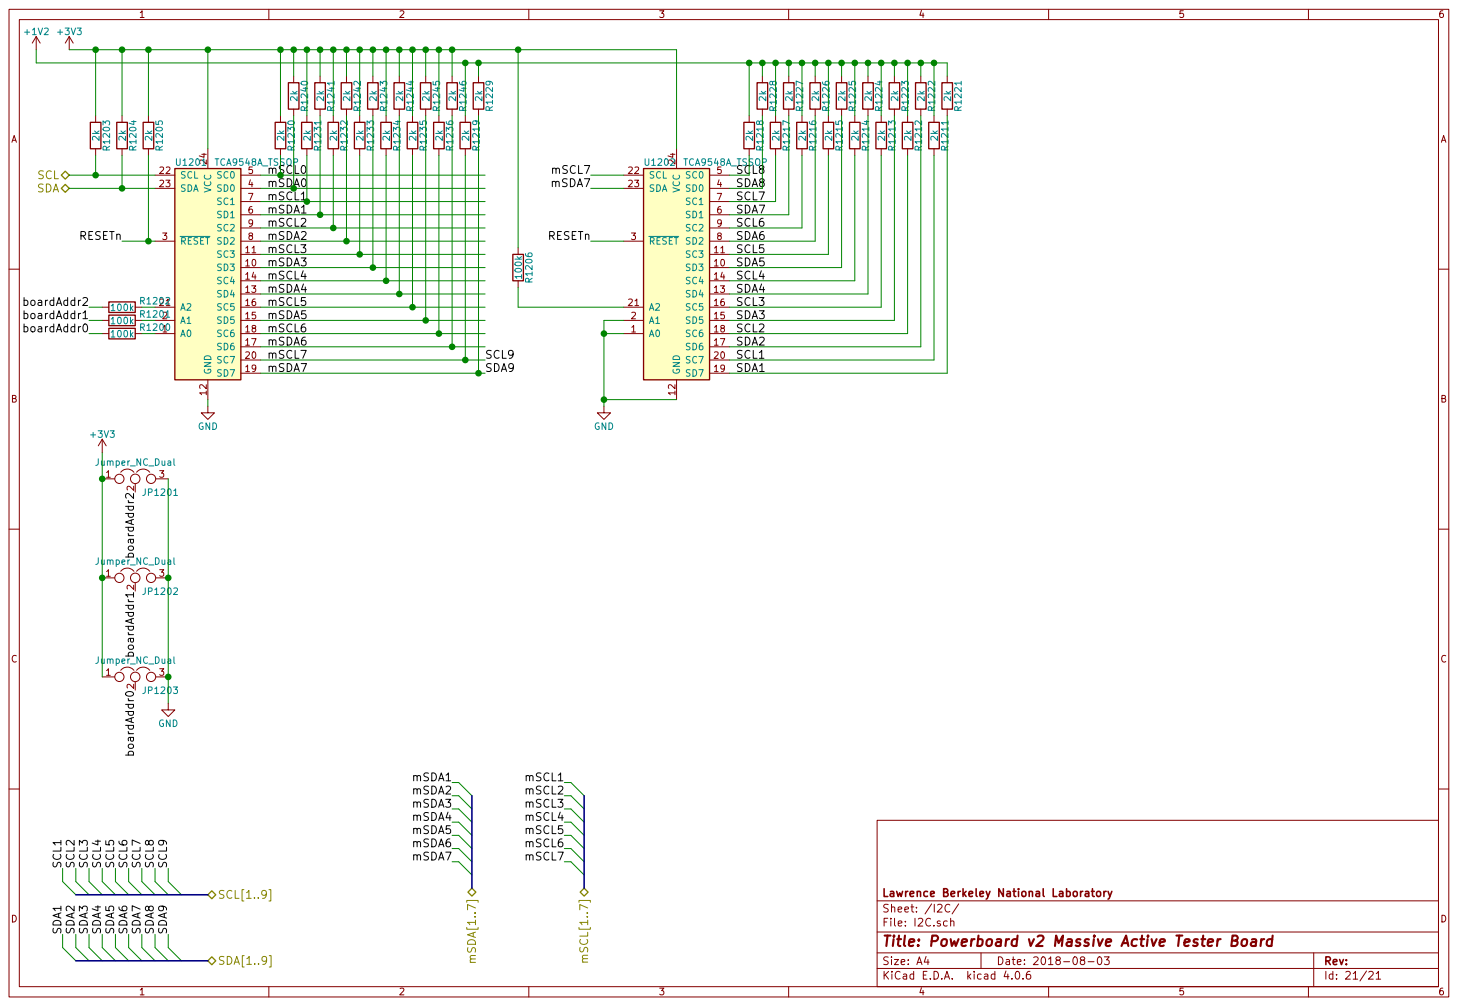
[picture p21: page 21]

File: I2C.sch Sheet: /I2C/ Lawrence Berkeley National Laboratory

Id: 21/21 Title: Powerboard v2 Massive Active Tester Board
