kkrizka/powerboard_mass_test_adapter_active/(threads)

Thread 1 (2018-07-02):

Comments from Timon

kkrizka, 2018-07-02:
* we should consider a more beefy power input solution, screw terminals
* Add generic monitoring ADC
 * input voltage, input current
 * random temperatures
* Add LEDs
* Make them daisy chainable and only support 9 PBs panel
* Add generic IO header
* Remove fast ADC, use external connector for testing
* Should include jumpers at all possible ends for calibration
* Is the ADP123 enough to power everything on the 3V3, 1V5, 2V5 rails?

kkrizka, 2018-07-03:
For LV power input:
https://www.digikey.com/product-detail/en/phoenix-contact/1714971/277-1271-ND/260639
2-terminal wire to board block. 30A per input.

Could power an entire panel of 27 Powerboards, as originally planned.

kkrizka, 2018-07-03:
Reduced support for only 9PBs.

Added daisy chain functionality.
* 2x4 connectors on top and bottom.
* 1st row is +5/-5, SCL,SDA.
* 2nd row is GND.
* Passing +5/-5 reduces amount of connections necessary to the power supply.
* 2 pins used for +5/-5 each. A [28 AWG wire](http://multimedia.3m.com/mws/media/667945O/3mtm-round-conductor-flat-cable-hf365-series-ts2334.pdf
) can carry [0.2A](http://www.powerstream.com/Wire_Size.htm). This allows 0.4A of power, which should be more than enough. This number will be revisited once the power usage is calculated at the end.

I2C addressing scheme is as follows.
* There are two levels of 8-channel I2C multiplexers.
* The connection to the MicroZed (or daisy chain connector) is iSCL, pulled to 3.3V and connected to the top I2C mutliplexer.
* Channel 0 of the top I2C mux is connected to 1.2V and drives PBV1
* Channel 1 of the top I2C mux is connected to 3.3V and called mI2C1. It is connected to second I2C mux.
* All channels of the second I2C mux are connected to PBs 2 to 9.
* mI2C1 is connected to active board devices.
* All except ch0 of the top multiplexer are connected to 3.3V and driven to individual PMOD connectors. This might be removed if layout proves to be difficult.
* The address of the top level mux can be set using resistors. This is to be used for daisy chaining. The controller should disable a board by moving the active channel to some high unused channel.

kkrizka, 2018-07-03:
Switched ADCs to single-ended 8-channel devices: [AD7997BRUZ-1-ND](http://www.analog.com/media/en/technical-documentation/data-sheets/AD7997_7998.pdf).

The result is 7 general ADCs that can be used for monitoring of single ended stuff. They have been connected to 7 [10k NTCs](https://product.tdk.com/info/en/catalog/datasheets/503021/tpd_commercial_ntc-thermistor_ntcg_en.pdf).

kkrizka, 2018-07-04:
Added a 4-channel ADC for monitoring: [AD7994BRUZ-0-ND](http://www.analog.com/media/en/technical-documentation/data-sheets/AD7993_7994.pdf).

The channels are:
* input 11V voltage (divided)
* input 11V current ([INA138](https://www.ti.com/lit/ds/sbos122e/sbos122e.pdf) + shunt)
* input +5V current (shunt + )
* input -5V current (shunt + )

kkrizka, 2018-07-06:
Added LEDs on generated power (3.3V and 1.2V).
Added LEDs on VOUT and HVOUT, activated via [MOSFET](https://assets.nexperia.com/documents/data-sheet/BSH105.pdf).

kkrizka, 2018-07-06:
Connected 10 MicroZed pin pairs from JX1 and JX2. The JX2 pairs can be used as XADC.

kkrizka, 2018-07-06:
Estimate of power usage on the 3V3 rail is here:
https://docs.google.com/spreadsheets/d/1c_CqOJ6KM3F9EMvHpv6GOa4JeiGMZDCuaSTdpWJs-1k/edit?usp=sharing

The total power on is 120 mA, with majority comming from the I/O banks (might be lower, since we don't use them as much) and LEDs.

The ADP123 can drive 300 mA maximum, so all is good for one board. In case of daisy chaining, this should be good for 4 boards in total. The I/O bank is only needed once and consumes 70 mA.
