kkrizka/powerboard_mass_test_adapter_active/(commit log)

2017-09-20 Initial import.
    [pbv2_mass_test_adapter_active.kicad_pcb, pbv2_mass_test_adapter_active.sch]
2017-09-21 Added I2C multiplexers.
    [I2C.sch, microzed.sch, pbv2_mass_test_adapter_active.kicad_pcb, pbv2_mass_test_adapter_active.sch]
2017-09-23 Implement a load circuit for LV testing.
    [I2C.sch, LVMeasure.sch, microzed.sch, pbv2_mass_test_adapter_active.sch]
2017-09-23 Add a ADC to measure LV.
    [LVMeasure.sch]
2017-09-26 Expanded LV measuring to 32 inputs.
    [I2C.sch, LVLoad4.sch, LVMeasure.sch, microzed.sch, pbv2_mass_test_adapter_active.sch]
2017-09-26 Added basic HV measure circuit.
    [HVLoad.sch, HVMeasure.sch, I2C.sch, LVLoad4.sch, LVMeasure.sch, microzed.sch, pbv2_mass_test_adapter_active.sch]
2017-09-26 Finished HV measuring circuit.
    [HVLoad.sch, HVMeasure.sch, I2C.sch, LVLoad4.sch, LVMeasure.sch, microzed.sch, pbv2_mass_test_adapter_active.sch]
2017-11-28 Add BaseBoardConnector for connection with the PB base board.
    [BaseBoardConnector.sch, BaseBoardConnectors.sch, HVMeasure.sch, I2C.sch, LVLoad4.sch, LVMeasure.sch, microzed.sch, pbv2_mass_test_adapter_active.sch]
2017-11-28 Start making connections between base board and active components.
    [BaseBoardConnector.sch, HVMeasure.sch, LVLoad4.sch, LVMeasure.sch, pbv2_mass_test_adapter_active.sch]
2017-11-28 Make a bus patch sheet for BBC connector.
    [BBCPatch3.sch]
2017-11-28 Connect base board connectors to the active components.
    [BB2ABPatch.sch]
2017-11-28 Add global power inputs.
    [PowerConnectors.sch]
2017-12-01 Fix stuff.
    [BB2ABPatch.sch, BBCPatch3.sch, BaseBoardConnector.sch, BaseBoardConnectors.sch, HVMeasure.sch, I2C.sch, LVLoad4.sch, LVMeasure.sch]
2017-12-04 Add missing capacitors on LV load DAC.
    [LVLoad4.sch, LVMeasure.sch]
2017-12-04 Add LDO's for power.
    [BB2ABPatch.sch, BBCPatch3.sch, BaseBoardConnector.sch, BaseBoardConnectors.sch, HVMeasure.sch, I2C.sch, LVLoad4.sch, LVMeasure.sch]
2017-12-04 Connect Zynq to power.
    [Power.sch, microzed.sch, pbv2_mass_test_adapter_active.sch]
2017-12-04 Connect I2C to the Zynq.
    [microzed.sch, pbv2_mass_test_adapter_active.sch]
2017-12-05 Add filters to power inputs.
    [PowerConnectors.sch]
2017-12-06 Add more KiCad fiels to gitignore.
2017-12-06 Add KK's kicad-components as a submodule.
2017-12-08 Fix a bunch of warnings.
    [BB2ABPatch.sch, BBCPatch3.sch, BaseBoardConnector.sch, BaseBoardConnectors.sch, HVMeasure.sch, I2C.sch, LVLoad4.sch, LVMeasure.sch]
2017-12-08 Update component references to be consistent within a sheet.
    [BB2ABPatch.sch, BaseBoardConnector.sch, HVMeasure.sch, I2C.sch, LVLoad4.sch, LVMeasure.sch, Power.sch, PowerConnectors.sch]
2018-01-08 Update MCP3428 symbol to one included with KiCAD 4.0.7.
    [BB2ABPatch.sch, BaseBoardConnector.sch, HVMeasure.sch, I2C.sch, LVLoad4.sch, LVMeasure.sch, Power.sch, PowerConnectors.sch]
2018-01-08 Update footprint associations. Update ADP123 symbol.
    [BB2ABPatch.sch, BaseBoardConnector.sch, HVMeasure.sch, I2C.sch, LVLoad4.sch, LVMeasure.sch, Power.sch, PowerConnectors.sch]
2018-06-29 Replace one of the two 2.5V LDOs with a 3.3V one.
    [BB2ABPatch.sch, BBCPatch3.sch, BaseBoardConnector.sch, BaseBoardConnectors.sch, HVMeasure.sch, I2C.sch, LVLoad4.sch, LVMeasure.sch]
2018-07-02 Update LV load circuit. Add coil measurement circuit.
    [BB2ABPatch.sch, BBCPatch3.sch, BaseBoardConnector.sch, BaseBoardConnectors.sch, Coils.sch, HVMeasure.sch, I2C.sch, LVLoad4.sch]
2018-07-03 Use terminal block for power input.
    [BB2ABPatch.sch, BaseBoardConnector.sch, Coils.sch, HVMeasure.sch, I2C.sch, LVLoad4.sch, LVMeasure.sch, Power.sch]
2018-07-03 Reduce to 9 Powerboards.
    [BB2ABPatch.sch, BBCPatch3.sch, BaseBoardConnector.sch, BaseBoardConnectors.sch, Coils.sch, HVLoad.sch, HVMeasure.sch, I2C.sch]
2018-07-03 Add 3.3V PMOD I2C extensions.
    [PMOD_I2C.sch, PMOD_I2C_7.sch]
2018-07-03 Add daisy chain connectors.
    [BaseBoardConnector.sch, DaisyConnector.sch, HVMeasure.sch, I2C.sch, LVLoad1.sch, LVLoad4.sch, LVMeasure.sch, ManualConnector.sch]
2018-07-03 The address of the main I2C multiplexer can be set using resistors.
    [DaisyConnector.sch, HVMeasure.sch, I2C.sch, LVLoad1.sch, LVLoad4.sch, LVMeasure.sch, PMOD_I2C_7.sch, Power.sch]
2018-07-03 Increase number of +5/-5 connections for daisy chain.
    [DaisyConnector.sch, HVMeasure.sch, I2C.sch, LVLoad1.sch, LVLoad4.sch, LVMeasure.sch, PMOD_I2C_7.sch, Power.sch]
2018-07-03 Use single-ended ADC for VOUT measurement. AD7997.
    [BaseBoardConnector.sch, DaisyConnector.sch, HVMeasure.sch, I2C.sch, LVLoad1.sch, LVLoad4.sch, LVMeasure.sch, ManualConnector.sch]
2018-07-03 Add 7 NTCs.
    [DaisyConnector.sch, HVMeasure.sch, I2C.sch, LVLoad1.sch, LVLoad4.sch, LVMeasure.sch, PMOD_I2C_7.sch, Power.sch]
2018-07-06 Add status LEDs. Add power monitoring.
    [BaseBoardConnector.sch, DaisyConnector.sch, HVMeasure.sch, I2C.sch, LVLoad1.sch, LVLoad4.sch, LVMeasure.sch, ManualConnector.sch]
2018-07-06 Add connector with a few MicroZed pins.
    [DaisyConnector.sch, HVMeasure.sch, I2C.sch, LVLoad1.sch, LVLoad4.sch, LVMeasure.sch, PMOD_I2C_7.sch, Power.sch]
2018-07-06 Added a few pins with 3.3V output.
    [DaisyConnector.sch, HVMeasure.sch, I2C.sch, LVLoad1.sch, LVLoad4.sch, LVMeasure.sch, PMOD_I2C_7.sch, Power.sch]
2018-07-06 Fix 3V3 symbol. Use 3.3V to power the DACs.
    [HVMeasure.sch, LVLoad1.sch, LVLoad4.sch, LVMeasure.sch, ManualConnector.sch, Power.sch, PowerConnectors.sch]
2018-07-06 Boost PWR_EN to 3.3V from 1.8V.
    [BaseBoardConnector.sch, DaisyConnector.sch, HVMeasure.sch, I2C.sch, LVLoad1.sch, LVLoad4.sch, LVMeasure.sch, ManualConnector.sch]
2018-07-06 Add jumper to connect PWR_EN to GND when running in daisy chain.
    [DaisyConnector.sch, I2C.sch, PMOD_I2C_7.sch, Power.sch]
2018-07-06 Move I2C to MicroZed PS PMOD. Update library symbols to KiCad 4.0.7.
    [HVMeasure.sch, PowerConnectors.sch, microzed.sch, pbv2_mass_test_adapter_active.sch]
2018-07-06 Footprint associations mostly completed.
    [BaseBoardConnector.sch, DaisyConnector.sch, HVMeasure.sch, I2C.sch, LVLoad1.sch, LVLoad4.sch, LVMeasure.sch, ManualConnector.sch]
2018-07-06 Start layout of variable load.
    [BaseBoardConnector.sch, LVLoad4.sch, pbv2_mass_test_adapter_active.kicad_pcb]
2018-07-06 Start of layout.
    [BaseBoardConnector.sch, DaisyConnector.sch, HVMeasure.sch, I2C.sch, LVLoad1.sch, LVLoad4.sch, LVMeasure.sch, ManualConnector.sch]
2018-07-07 Work on LV load layout.
    [LVLoad4.sch, LVMeasure.sch, pbv2_mass_test_adapter_active.kicad_pcb]
2018-07-07 Load layout progress.
    [LVLoad4.sch, PowerConnectors.sch, microzed.sch, pbv2_mass_test_adapter_active.kicad_pcb]
2018-07-07 Finish layout of left side of load.
    [BaseBoardConnector.sch, DaisyConnector.sch, HVMeasure.sch, I2C.sch, LVLoad1.sch, LVLoad4.sch, LVMeasure.sch, ManualConnector.sch]
2018-07-07 Fixed to left loads. Start on right loads.
    [LVLoad4.sch, LVMeasure.sch, pbv2_mass_test_adapter_active.kicad_pcb]
2018-07-07 Add vias to right load.
    [pbv2_mass_test_adapter_active.kicad_pcb]
2018-07-07 Place NTCs.
    [LVMeasure.sch, pbv2_mass_test_adapter_active.kicad_pcb]
2018-07-07 Use pin header for manual VOUT.
    [LVMeasure.sch, ManualConnector.sch, PMOD_I2C.sch, pbv2_mass_test_adapter_active.kicad_pcb]
2018-07-08 Add big VIN strip.
    [LVMeasure.sch, ManualConnector.sch, PowerConnectors.sch, pbv2_mass_test_adapter_active.kicad_pcb]
2018-07-08 DaisyChain VIN.
    [DaisyConnector.sch, pbv2_mass_test_adapter_active.kicad_pcb, pbv2_mass_test_adapter_active.sch]
2018-07-08 Layout second level of I2C.
    [I2C.sch, pbv2_mass_test_adapter_active.kicad_pcb]
2018-07-08 Layout first level level of I2C.
    [I2C.sch, pbv2_mass_test_adapter_active.kicad_pcb]
2018-07-08 Add jumpers for I2C board addres select.
    [I2C.sch, pbv2_mass_test_adapter_active.kicad_pcb]
2018-07-08 Add indication of where cold plate is.
    [pbv2_mass_test_adapter_active.kicad_pcb]
2018-07-08 Use thr pin headers for board address jumpers.
    [DaisyConnector.sch, I2C.sch, LVLoad4.sch, PMOD_I2C.sch, PMOD_I2C_7.sch, pbv2_mass_test_adapter_active.kicad_pcb]
2018-07-08 Layout LDOs.
    [I2C.sch, Power.sch, PowerConnectors.sch, pbv2_mass_test_adapter_active.kicad_pcb]
2018-07-11 Layout the LV measure.
    [HVMeasure.sch, LVMeasure.sch, pbv2_mass_test_adapter_active.kicad_pcb]
2018-07-11 Remove vin daisy chain.
    [DaisyConnector.sch, LVMeasure.sch, PMOD_I2C.sch, pbv2_mass_test_adapter_active.kicad_pcb]
2018-07-11 Update VIN zones.
    [pbv2_mass_test_adapter_active.kicad_pcb]
2018-07-11 Place daisy chain connectors.
    [pbv2_mass_test_adapter_active.kicad_pcb]
2018-07-17 Layout HV LEDs.
    [HVMeasure.sch, PMOD_I2C.sch, PowerConnectors.sch, pbv2_mass_test_adapter_active.kicad_pcb]
2018-07-17 Layout power enable.
    [pbv2_mass_test_adapter_active.kicad_pcb]
2018-07-20 Connect all I2C lines.
    [pbv2_mass_test_adapter_active.kicad_pcb]
2018-07-20 Move LV ADS to the left.
    [pbv2_mass_test_adapter_active.kicad_pcb]
2018-07-20 More layout.
    [HVMeasure.sch, pbv2_mass_test_adapter_active.kicad_pcb]
2018-07-20 Tie HV_RTN to ground.
    [HVMeasure.sch, pbv2_mass_test_adapter_active.kicad_pcb]
2018-07-31 Update microzed connections.
    [DaisyConnector.sch, PowerConnectors.sch, microzed.sch, pbv2_mass_test_adapter_active.kicad_pcb, pbv2_mass_test_adapter_active.sch]
2018-07-31 Connect one of the FPGA pin breakouts.
    [pbv2_mass_test_adapter_active.kicad_pcb]
2018-07-31 Move JZ1 breakout a bit lower.
    [pbv2_mass_test_adapter_active.kicad_pcb]
2018-08-01 Route JZ1 breakout.
    [pbv2_mass_test_adapter_active.kicad_pcb]
2018-08-01 Connect -5V.
    [DaisyConnector.sch, HVMeasure.sch, I2C.sch, PMOD_I2C_7.sch, Power.sch, PowerConnectors.sch, pbv2_mass_test_adapter_active.kicad_pcb]
2018-08-01 Connect +5V.
    [pbv2_mass_test_adapter_active.kicad_pcb]
2018-08-01 Route 3.3V.
    [pbv2_mass_test_adapter_active.kicad_pcb]
2018-08-01 GND and 3.3V routing.
    [pbv2_mass_test_adapter_active.kicad_pcb]
2018-08-02 Work on fixing DRC errors.
    [pbv2_mass_test_adapter_active.kicad_pcb]
2018-08-02 HV = V-, HV_RTN = V+ on the ADC measuring thing.
    [DaisyConnector.sch, HVMeasure.sch, I2C.sch, ManualConnector.sch, PMOD_I2C.sch, PMOD_I2C_7.sch, Power.sch, microzed.sch]
2018-08-02 Route HV_OUT connector.
    [pbv2_mass_test_adapter_active.kicad_pcb]
2018-08-02 Reconnect HV LEDS.
    [pbv2_mass_test_adapter_active.kicad_pcb]
2018-08-02 Power HV LEDs from -5V.
    [DaisyConnector.sch, HVMeasure.sch, I2C.sch, LVLoad4.sch, PMOD_I2C.sch, PMOD_I2C_7.sch, Power.sch, PowerConnectors.sch]
2018-08-03 Add holes. Fix position of cold plate.
    [BaseBoardConnector.sch, DaisyConnector.sch, HVMeasure.sch, I2C.sch, LVLoad1.sch, LVLoad4.sch, LVMeasure.sch, ManualConnector.sch]
2018-08-03 Place one hole.
    [pbv2_mass_test_adapter_active.kicad_pcb]
2018-08-03 Fix width of cold plate.
    [DaisyConnector.sch, HVMeasure.sch, I2C.sch, LVLoad1.sch, LVLoad4.sch, LVMeasure.sch, PMOD_I2C_7.sch, Power.sch]
2018-08-03 Place second (final) screw hole.
    [pbv2_mass_test_adapter_active.kicad_pcb, pbv2_mass_test_adapter_active.sch]
2018-08-03 Fix an HV measurement line.
    [pbv2_mass_test_adapter_active.kicad_pcb]
2018-08-03 Export gerbers.
    [pbv2_mass_test_adapter_active-B.Cu.gbr, pbv2_mass_test_adapter_active-B.Mask.gbr, pbv2_mass_test_adapter_active-B.SilkS.gbr, pbv2_mass_test_adapter_active-Dwgs.User.gbr, pbv2_mass_test_adapter_active-Edge.Cuts.gbr, pbv2_mass_test_adapter_active-F.Cu.gbr, pbv2_mass_test_adapter_active-F.Mask.gbr, pbv2_mass_test_adapter_active-F.SilkS.gbr]
2018-08-03 Add schematics in PDF.
    [pbv2_mass_test_adapter_active.kicad_pcb]
2018-08-03 Cleanup HVMeasure references and silkscreen.
    [BaseBoardConnector.sch, DaisyConnector.sch, HVMeasure.sch, I2C.sch, LVLoad1.sch, LVLoad4.sch, LVMeasure.sch, ManualConnector.sch]
2018-08-03 Start of cleanup LVMeasure references and silkscreen.
    [HVMeasure.sch, LVLoad1.sch, LVLoad4.sch, pbv2_mass_test_adapter_active.kicad_pcb]
2018-08-04 Finish cleanup of LVMeasure references and silkscreen.
    [HVMeasure.sch, LVLoad1.sch, LVLoad4.sch, LVMeasure.sch, pbv2_mass_test_adapter_active.kicad_pcb]
2018-08-04 Add ADC LVMeasure references and silkscreen.
    [pbv2_mass_test_adapter_active.kicad_pcb]
2018-08-04 Cleanup I2C silkscreen.
    [I2C.sch, pbv2_mass_test_adapter_active.kicad_pcb]
2018-08-04 Silkscreen work.
    [BaseBoardConnector.sch, DaisyConnector.sch, ManualConnector.sch, PMOD_I2C.sch, Power.sch, PowerConnectors.sch, microzed.sch, pbv2_mass_test_adapter_active.kicad_pcb]
2018-08-04 Improve varload silkscreen labelling.
    [LVLoad1.sch, LVLoad4.sch, PMOD_I2C.sch, pbv2_mass_test_adapter_active.kicad_pcb]
2018-08-06 Fixes to the MicroZed footprint.
    [pbv2_mass_test_adapter_active-B.Cu.gbr, pbv2_mass_test_adapter_active-B.Mask.gbr, pbv2_mass_test_adapter_active-B.SilkS.gbr, pbv2_mass_test_adapter_active-Dwgs.User.gbr, pbv2_mass_test_adapter_active-Edge.Cuts.gbr, pbv2_mass_test_adapter_active-F.Cu.gbr, pbv2_mass_test_adapter_active-F.Mask.gbr, pbv2_mass_test_adapter_active-F.SilkS.gbr]
2018-08-07 Fix a few footprints based on component availability.
    [HVMeasure.sch, LVLoad4.sch, Power.sch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]
2018-08-07 Add Bill of Materials.
    [bom.ods]
2018-08-07 Add NTC to BoM.
    [bom.ods]
